andykarpov/karabas-go-pcb/README.md

# Karabas-Go PCB

A Spartan-6 based devboard.

### Pre-production renders:

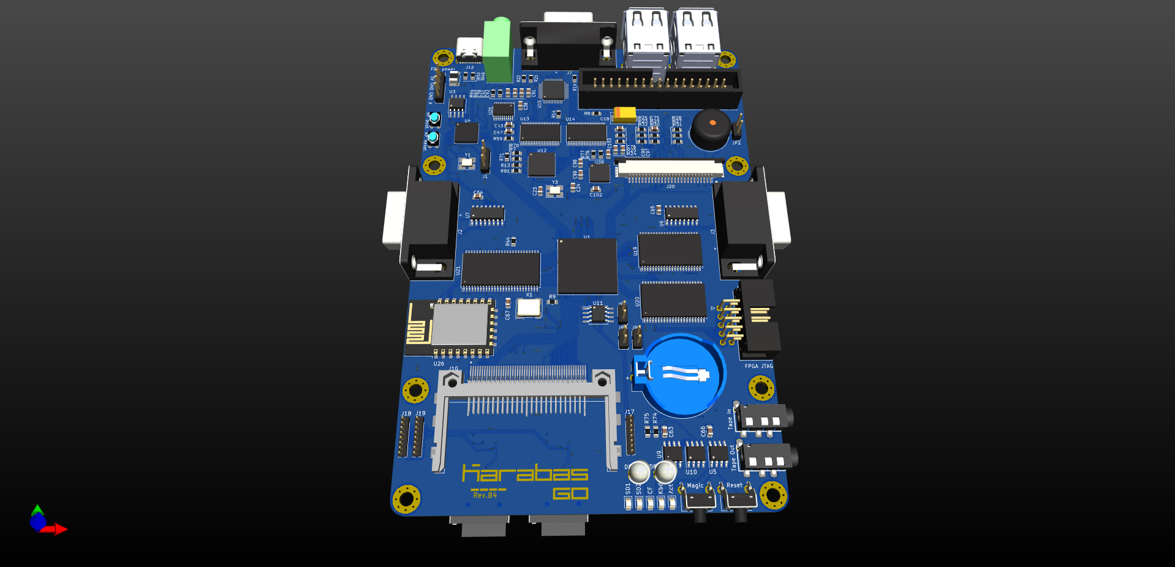
[picture p1: karabas-go-top.png]


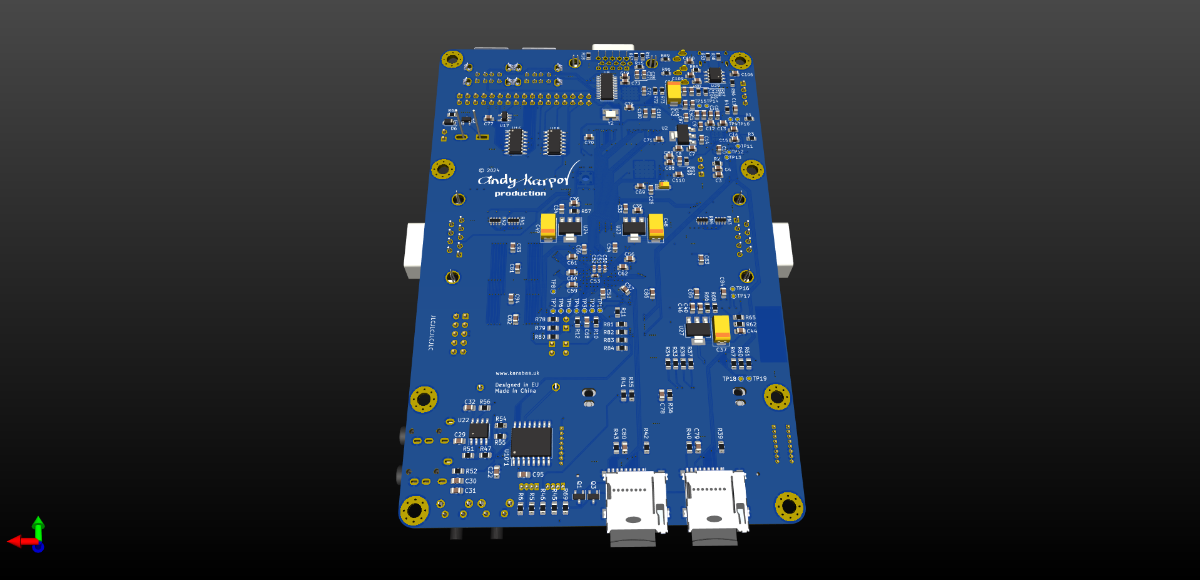
[picture p2: karabas-go-bot.png]
