andykarpov/karabas-go-pcb/Hotfix-DSKCHG_rus.md

# Доработка: DSKCHG разъёма дисковода (все ревизии A..C)

Pin 34 разъёма J8 (DSKCHG, «диск сменён») на плате не используется, поэтому ядра могли только
угадывать, когда диск вынули или вставили. Доработка заводит pin 34 на RP2040, прошивка передаёт
сигнал ядру (`CMD_FDD_CHNG`, karabas-go-firmware `docs/protocol.md`). Платы без доработки работают
как раньше.

Схема этого места одинакова во всех ревизиях от A до C: у U18 (74LVC14, SO-14) свободен один
инвертор (вход pin 5 на GND, выход pin 6 никуда не подключён), TP15 (RP2040 GPIO28) — свободная
контрольная точка.

## Что сделать

1. U18 pin 5: отогнуть ногу от площадки (площадка — GND). В воздухе её не оставлять.
2. Соединить J8 pin 34 с отогнутой ногой U18 pin 5.
3. Резистор 1k с U18 pin 5 на VCC (+5 V), как R23..R26 у INDEX / TR00 / WPRT / RDATA. Выход
   дисковода — открытый коллектор: подтяжка ставится на плате, а не в дисководе. Вход 74LVC
   выдерживает 5 V.
4. Соединить U18 pin 6 с TP15 (GPIO28).

Через инвертор на GPIO28 высокий уровень, когда выбранный дисковод сообщает о смене диска.

## Проверка

С `debug=1` в `karabas.ini` прошивка при старте пишет в лог:

- `Floppy DSKCHG line on GPIO28 (hotfix)` — провод на месте;
- `No floppy DSKCHG line` — GPIO28 свободна (доработки нет или нет контакта с U18 pin 6).

Прошивка читает GPIO28 с подтяжкой вверх и с подтяжкой вниз: свободная площадка идёт за
подтяжкой, а выход инвертора держит уровень сам.

## Дисководы

PC-дисководы 3.5" выдают DSKCHG на pin 34. У некоторых есть перемычка DC / RDY, которая выводит
туда READY: её нужно поставить в DC. У дисководов Amiga на pin 2 стоит _CHNG, а на pin 34 _RDY,
для них нужен PC-дисковод или переходник.

## Следующая ревизия

Развести U18 pin 6 на GPIO28 и на плате (тогда одна прошивка и одни битстримы для всех плат).
