andykarpov/karabas-go-pcb/fab/karabas-go-bom-slx25.xlsx

Comment | Designator | Footprint | JLCPCB Part #（optional）
XC6SLX25-FTG256 | U1 | BGA-256_17.0x17.0mm_Layout16x16_P1.0mm_Ball0.5mm_Pad0.4mm_NSMD | C41894
