andykarpov/karabas-go-pcb/fab/karabas-go-bom.xlsx

Comment | Designator | Footprint | JLCPCB Part #（optional）
RP Boot | BTN1 | SW_SPST_PTS810_handsoldering | C221896
RP Reset | BTN2 | SW_SPST_PTS810_handsoldering | C221896
10uF | C18,C20 | CP_EIA-7343-31_Kemet-D-uni | C167093
18pF | C23,C24 | C_0805_2012Metric_Pad1.18x1.45mm_HandSolder | C1797
4u7 | C25 | C_0805_2012Metric_Pad1.18x1.45mm_HandSolder | C1779
22pF | C3,C4 | C_0805_2012Metric_Pad1.18x1.45mm_HandSolder | C1804
3n3 | C31 | C_0805_2012Metric_Pad1.18x1.45mm_HandSolder | C1744
100uF | C37,C48,C49 | CP_EIA-7343-31_Kemet-D-uni | C710451
2n2 | C38,C42,C45 | C_0805_2012Metric_Pad1.18x1.45mm_HandSolder | C28260
10u | C43,C39,C7,C1 | C_0805_2012Metric_Pad1.18x1.45mm_HandSolder | C15850
100n | C57,C61,C60,C54,C50,C52,C53,C51,C59,C55,C58,C62,C56 | C_0402_1005Metric_Pad0.74x0.62mm_HandSolder | C1525
100n | C65,C63,C17,C41,C75,C66,C67,C76,C21,C77,C22,C64,C47,C27,C34,C72,C71,C84,C15,C74,C26,C32,C13,C79,C11,C70,C36,C16,C68,C33,C78,C12,C81,C5,C14,C10,C46,C94,C19,C69,C73,C87,C44,C93,C85,C83,C40,C29,C6,C80,C86,C35,C9,C82,C30 | C_0805_2012Metric_Pad1.18x1.45mm_HandSolder | C49678
1u | C8,C28,C2 | C_0805_2012Metric_Pad1.18x1.45mm_HandSolder | C28323
4n7 | C88,C90,C89 | C_0805_2012Metric_Pad1.18x1.45mm_HandSolder | C1744
470n | C91,C92 | C_0805_2012Metric_Pad1.18x1.45mm_HandSolder | C13967
Keyboard | D1 | LED_0805_2012Metric_Pad1.15x1.40mm_HandSolder | C2297
Activitty | D2 | LED_0805_2012Metric_Pad1.15x1.40mm_HandSolder | C84256
SD 2 | D4 | LED_0805_2012Metric_Pad1.15x1.40mm_HandSolder | C2296
CF | D5 | LED_0805_2012Metric_Pad1.15x1.40mm_HandSolder | C2296
1N4148W | D6 | D_SOD-123 | C81598
SD 1 | D7 | LED_0805_2012Metric_Pad1.15x1.40mm_HandSolder | C2296
6V 2A | F1 | Fuse_1812_4532Metric_Pad1.30x3.40mm_HandSolder | C883156
CF Card | J10 | TE_1734451-1-LONG | C2962036
USB C | J12 | USB_C_Receptacle_XKB_U262-16XN-4BVC11 | C2927037
uSD card | J9,J11 | Conn_uSDcard | C111196
BC856 | Q1,Q3 | SOT-23 | C8326
BC847 | Q2 | SOT-23 | C20526
10k | R14,R13,R44,R43,R62,R61,R10,R42,R12,R65,R3,R11,R60,R39,R4,R40,R68 | R_0805_2012Metric_Pad1.20x1.40mm_HandSolder | C17414
0* | R18 | R_0805_2012Metric_Pad1.20x1.40mm_HandSolder | C17477
75 | R20,R19,R16,R15,R17 | R_0805_2012Metric_Pad1.20x1.40mm_HandSolder | C17408
22 | R21 | R_0805_2012Metric_Pad1.20x1.40mm_HandSolder | C17561
510 | R22 | R_0805_2012Metric_Pad1.20x1.40mm_HandSolder | C17734
330 | R30,R27,R31,R28,R32,R29 | R_0805_2012Metric_Pad1.20x1.40mm_HandSolder | C17630
100 | R33,R34,R37,R38 | R_0805_2012Metric_Pad1.20x1.40mm_HandSolder | C17408
1M | R47 | R_0805_2012Metric_Pad1.20x1.40mm_HandSolder | C17514
0 | R49,R50 | R_0805_2012Metric_Pad1.20x1.40mm_HandSolder | C17477
33k | R52 | R_0805_2012Metric_Pad1.20x1.40mm_HandSolder | C17633
5k1 | R53,R51,R48 | R_0805_2012Metric_Pad1.20x1.40mm_HandSolder | C27834
300 | R57 | R_0805_2012Metric_Pad1.20x1.40mm_HandSolder | C17617
15k* | R58 | R_0805_2012Metric_Pad1.20x1.40mm_HandSolder | C17475
470 | R63,R64,R5,R6,R45,R46,R67,R69 | R_0805_2012Metric_Pad1.20x1.40mm_HandSolder | C17710
1k | R7,R23,R71,R26,R25,R70,R24,R59,R55,R66,R41,R36,R2,R35,R1,R54,R56 | R_0805_2012Metric_Pad1.20x1.40mm_HandSolder | C17513
10k* | R73,R72 | R_0805_2012Metric_Pad1.20x1.40mm_HandSolder | C17414
4k7 | R75,R74 | R_0805_2012Metric_Pad1.20x1.40mm_HandSolder | C17673
2k7 | R8 | R_0805_2012Metric_Pad1.20x1.40mm_HandSolder | C17530
27 | R9 | R_0805_2012Metric_Pad1.20x1.40mm_HandSolder | C17594
10k | RN4,RN3,RN1,RN2 | R_Array_Convex_4x0603 | C110924
XC6SLX25-FTG256 | U1 | BGA-256_17.0x17.0mm_Layout16x16_P1.0mm_Ball0.5mm_Pad0.4mm_NSMD | C41894
DS3231MZ | U10 | SO-8_3.9x4.9mm_P1.27mm | C107410
W25Q128JVSIQ | U11,U3 | SOIC-8_5.23x5.23mm_P1.27mm | C97521
FT812Q-T | U12 | QFN-56-1EP_8x8mm_P0.5mm_EP5.9x5.9mm_ThermalVias | C3824176
MC74LCX16245DT | U13,U14 | TSSOP-48_6.1x12.5mm_P0.5mm | C233628
ADV7125BCPZ170 | U15 | QFN-48-1EP_7x7mm_P0.5mm_EP5.1x5.1mm_ThermalVias | C662235
74LVC06 | U16 | SO-14_3.9x8.65mm_P1.27mm | C7658
74LVC1G06 | U17 | SOT-23-5_HandSoldering | C840103
74LVC14 | U18 | SO-14_3.9x8.65mm_P1.27mm | C354441
IS61WV20488BLL-10TLI | U19,U20 | TSOP-II-44_10.16x18.41mm_P0.8mm
LM1117MP-3.3 | U2,U27,U23 | SOT-223-3_TabPin2 | C498153
MT48LC16M16A2TG | U21 | TSOP-II-54_22.2x10.16mm_P0.8mm | C26393
LM311 | U22 | SO-8_3.9x4.9mm_P1.27mm | C2868397
LM1117MP-1.2 | U24 | SOT-223-3_TabPin2 | C126025
PCM5102A | U25 | TSSOP-20_4.4x6.5mm_P0.65mm | C107671
RP2040 | U4 | RP2040-QFN-56 | C2040
PCA9536D | U5 | SOIC-8_3.9x4.9mm_P1.27mm | C2688883
74HC597 | U7,U6 | SO-16_3.9x9.9mm_P1.27mm | C521193
FE1.1s | U8 | SSOP-28_3.9x9.9mm_P0.635mm | C9359
24LC08B | U9 | SO-8_3.9x4.9mm_P1.27mm | C5455
50 MHz | X1 | Oscillator_SMD_SeikoEpson_SG8002CA-4Pin_7.0x5.0mm | C387130
12MHz | Y1,Y2 | Crystal_SMD_3225-4Pin_3.2x2.5mm_HandSoldering | C9002
8MHz | Y3 | Crystal_SMD_3225-4Pin_3.2x2.5mm_HandSoldering | C367183
