andykarpov/karabas-go-pcb/3d_models/karabas-go-revB4.step

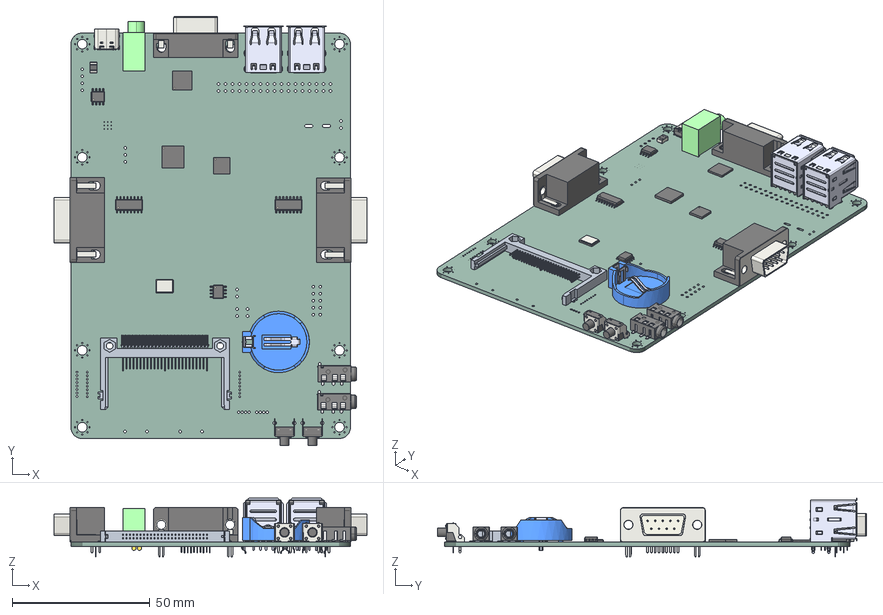
[picture p4: CAD file, 2026-05-14]
3d_models/karabas-go-revB4.step
113.7 x 155.9 x 21.4 mm
DSUB_30_female
Crystal_SMD_TXC_7M-4Pin_3.2x2.5mm_HandSoldering
SOIC_8_39x49mm_P127mm x 2
SW_Tactile_SPST_Angled_PTS645Vx58-2LFS x 2
BS-7-BLUE
Fuse_1210_3225Metric
USB_C_Receptacle_16P_TopMnt_Horizontal_GCT_USB4105-xx-A
QFN_56_1EP_8x8mm_Pitch05mm_EP52x45mm
DSUB-9_Male_Horizontal_P2.77x2.84mm_EdgePinOffset7.70mm_Housed_ MountingHolesOffset9.12mm x 2
SOIC_16_39x99mm_P127mm x 2
SS-52100-003 x 2
User Library-PJ325
PJ320D x 2
QFN-48-1EP_7x7mm_Pitch0.5mm
C-1734451-1
UQFN-48-1EP_6x6mm_Pitch0.4mm
karabas-go PCB
