andykarpov/karabas-go-pcb/Errata-revA_rus.txt

Хотфиксы revA:

1) засоплить между собой выводы 43 и 44 RP2040

2) C27 посажен на GND, желательно перекинуть его на ближайший VCC33

3) C38 должен быть 2.2мкФ, по бому неправильный - 2.2нФ

4) ноги 1,24 у буферов U13, U14 посажены на VCC33, надо отрезать их и засоплить ноги на GND
