andykarpov/karabas-go-pcb/(commit log)

2023-08-04 annotated schematics
2023-08-05 Changed memory to ISSI, some pcb placement wip
2023-08-11 revA gerbers, schematics
2023-08-11 fixed 7406 footprint
2023-12-31 PCB Rev.B - initial changes with all Rev.A hotfixes for the moment
2024-01-01 Added ADV7125 universal footprint QFN/QFP
2024-01-01 RevB compressed gerbers
2024-01-02 Fixed FE1.1 footprint, increased power rails width
2024-01-06 Updated revB pcb - changed footprints of the FPGA capacitors, swapped rp2040 test points
2024-01-06 Added revB gerbers
2024-01-06 Added revB schematics
2024-02-08 Updated buzzer footprint
2024-02-15 Added FT_PD reset circuit, routed to MCU TP9
2024-02-16 Added ext connector for 3rd SD card
2024-02-16 Updated revB2: added additional ext connectors for SD cards
2024-02-16 Silkscreen updates
2024-03-03 Compressed gerbers revB3
2024-04-09 Updated revB4 schematics
2026-05-14 3d models of the whole pcb (incomplete)
2026-11-01 Hotfix: DSKCHG (pin 34) of the floppy connector through the free gate of U18 to TP15 / GPIO28
    All revisions A..C: U18 (74LVC14) pin 5 lifted off GND, J8.34 to it with 1k to VCC, U18 pin 6
    to TP15 (RP2040 GPIO28). The firmware finds the wire and passes DSKCHG to the cores
    (CMD_FDD_CHNG of karabas-go-firmware).
