andykarpov/karabas-go-pcb/karabas-go.kicad_pcb

## KiCad design karabas-go.kicad_pcb (2024-04-09)

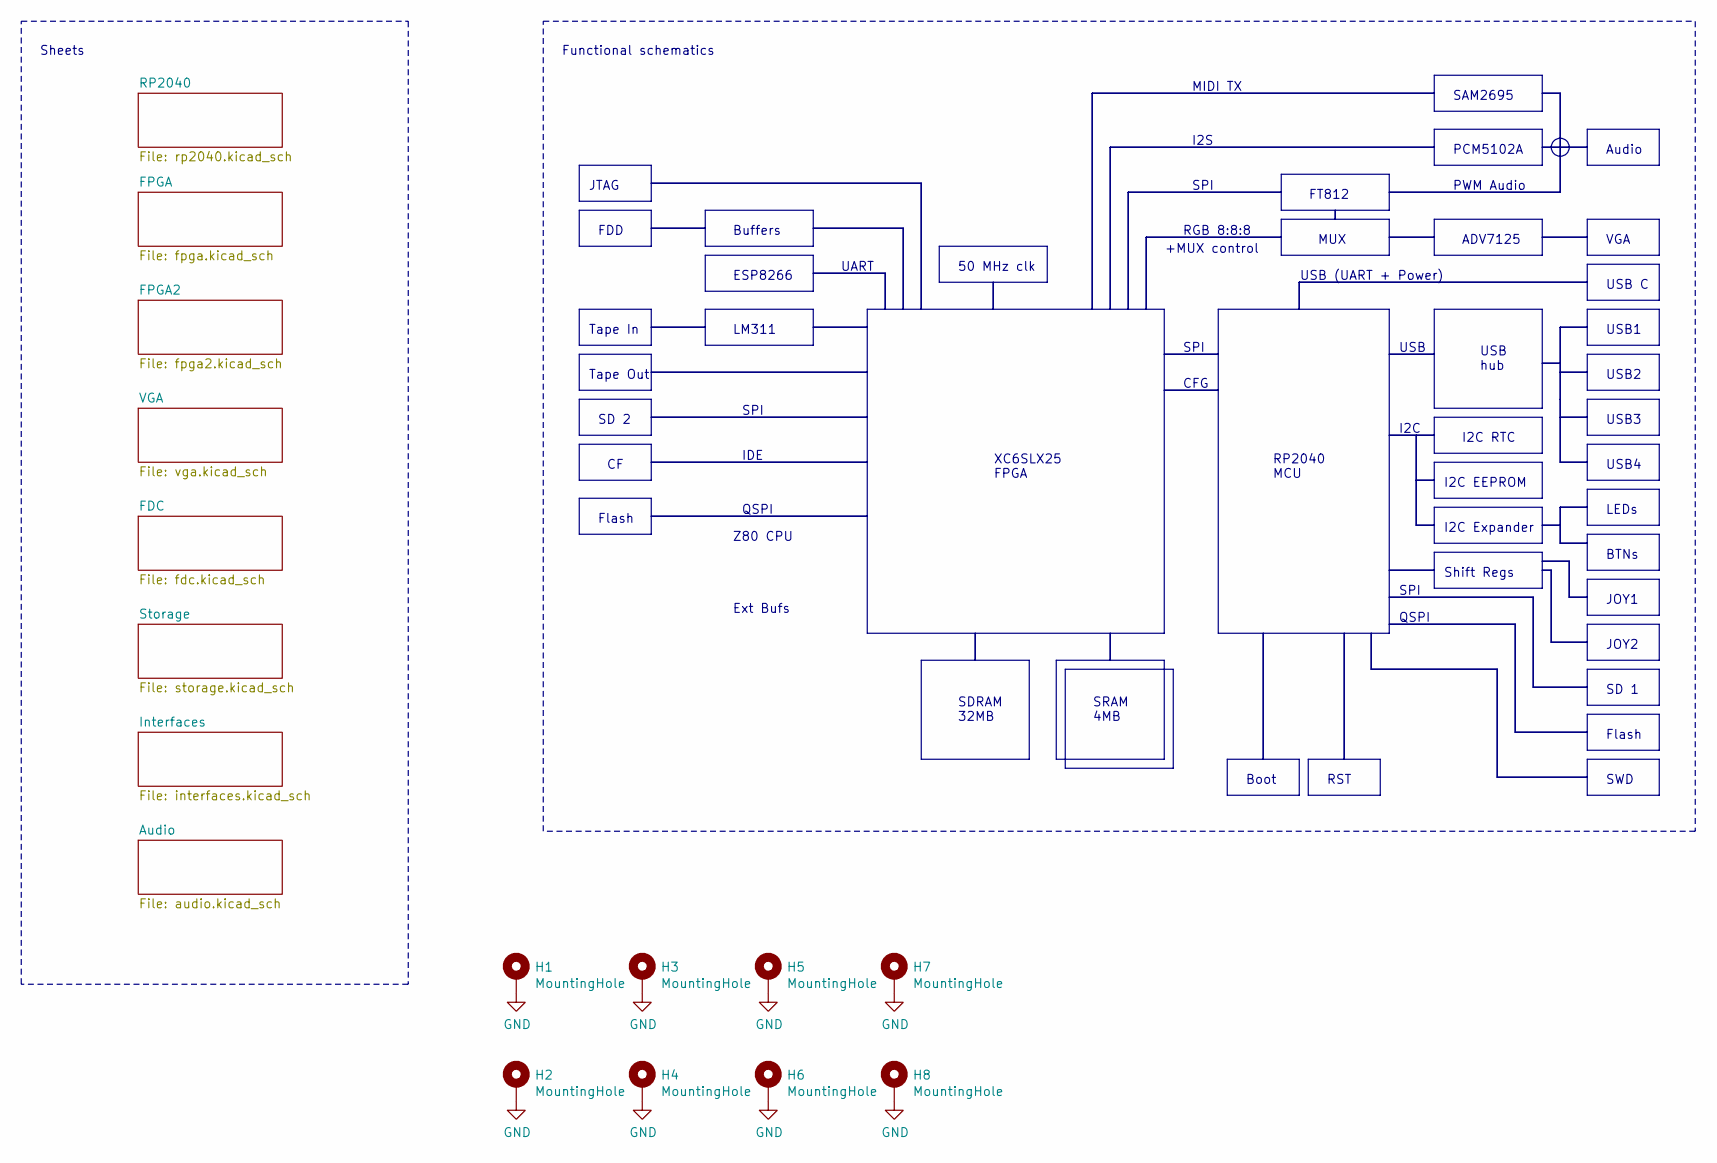
[picture p2: schematic karabas-go.kicad_sch]

Parts:
H1, H2, H3, H4, H5, H6, H7, H8: MountingHole; MountingHole_3.5mm_Pad_Via

Connections:
GND: H1.1, H2.1, H3.1, H4.1, H5.1, H6.1, H7.1, H8.1; also elsewhere on the board

Notes on the sheet:
QSPI
MIDI TX
I2C
I2C RTC
Tape Out
JTAG
SD 2
SAM2695
VGA
USB2
USB1
I2C EEPROM
JOY2
SWD
XC6SLX25 FPGA
RGB 8:8:8
Tape In
UART
RST
I2S
USB hub
50 MHz clk
SD 1
Z80 CPU
SPI
LM311
JOY1
IDE
ADV7125
Shift Regs
USB4
PWM Audio
Ext Bufs
SRAM 4MB
I2C Expander
FT812
+MUX control
Functional schematics
SDRAM 32MB
LEDs
CFG
USB (UART + Power)
USB C
Audio
USB
USB3
PCM5102A
Buffers
Boot
ESP8266
MUX
Flash
FDD
Sheets
BTNs
RP2040 MCU

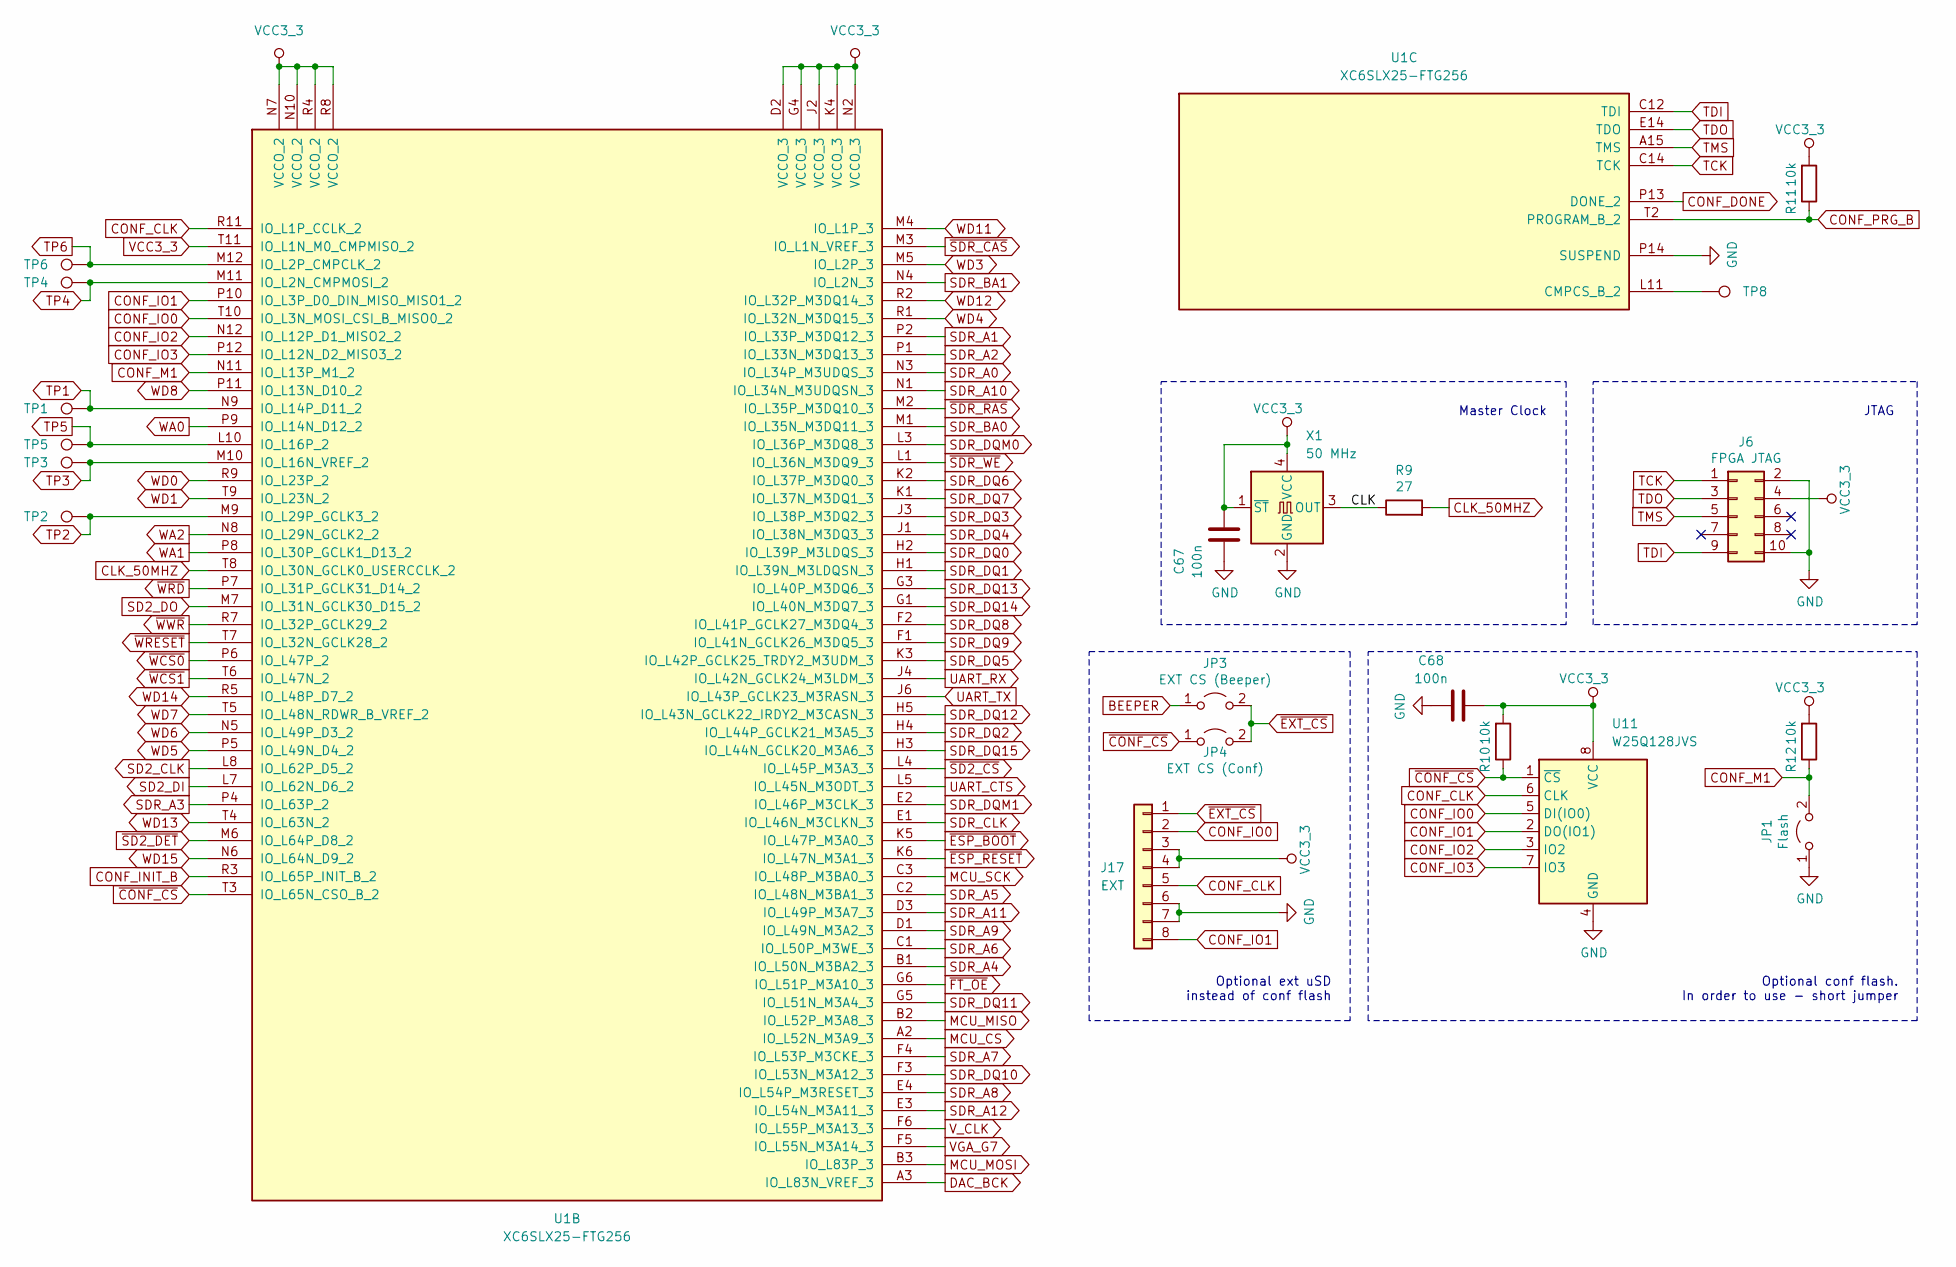
[picture p3: schematic fpga2.kicad_sch, Karabas-Go]

Parts:
C67, C68: 100n; C_0805_2012Metric_Pad1.18x1.45mm_HandSolder
J6: FPGA JTAG; IDC-Header_2x05_P2.54mm_Horizontal
J17: EXT; PinHeader_1x08_P1.27mm_Vertical
JP1: Flash; PinHeader_1x02_P2.54mm_Vertical
JP3: EXT CS (Beeper); PinHeader_1x02_P2.54mm_Vertical
JP4: EXT CS (Conf); PinHeader_1x02_P2.54mm_Vertical
R9: 27; R_0805_2012Metric_Pad1.20x1.40mm_HandSolder
R10, R11, R12: 10k; R_0805_2012Metric_Pad1.20x1.40mm_HandSolder
TP1, TP2, TP3, TP4, TP5, TP6, TP8: TestPoint; TestPoint_Pad_D1.0mm
U1: XC6SLX25-FTG256; BGA-256_17.0x17.0mm_Layout16x16_P1.0mm_Ball0.5mm_Pad0.4mm_N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
U11: W25Q128JVS; SOIC-8_5.23x5.23mm_P1.27mm
X1: 50 MHz; Oscillator_SMD_SeikoEpson_SG8002CA-4Pin_7.0x5.0mm

Connections:
/FPGA2/CLK: R9.1, X1.3 (OUT)
BEEPER: JP3.1 (A); also elsewhere on the board
CLK_50MHZ: R9.2, U1.T8 (IO_L30N_GCLK0_USERCCLK_2)
CONF_CLK: J17.5, U1.R11 (IO_L1P_CCLK_2), U11.6 (CLK); also elsewhere on the board
CONF_DONE: U1.P13 (DONE_2); also elsewhere on the board
CONF_INIT_B: U1.R3 (IO_L65P_INIT_B_2); also elsewhere on the board
CONF_IO0: J17.2, U1.T10 (IO_L3N_MOSI_CSI_B_MISO0_2), U11.5 (DI(IO0))
CONF_IO1: J17.8, U1.P10 (IO_L3P_D0_DIN_MISO_MISO1_2), U11.2 (DO(IO1)); also elsewhere on the board
CONF_IO2: U1.N12 (IO_L12P_D1_MISO2_2), U11.3 (IO2)
CONF_IO3: U1.P12 (IO_L12N_D2_MISO3_2), U11.7 (IO3)
CONF_M1: JP1.2 (B), R12.1, U1.N11 (IO_L13P_M1_2)
CONF_PRG_B: R11.1, U1.T2 (PROGRAM_B_2); also elsewhere on the board
DAC_BCK: U1.A3 (IO_L83N_VREF_3); also elsewhere on the board
GND: C67.2, C68.2, J6.2, J6.10, J17.6, J17.7, JP1.1 (A), U1.P14 (SUSPEND), U11.4 (GND), X1.2 (GND); also elsewhere on the board
MCU_CS: U1.A2 (IO_L52N_M3A9_3); also elsewhere on the board
MCU_MISO: U1.B2 (IO_L52P_M3A8_3); also elsewhere on the board
MCU_MOSI: U1.B3 (IO_L83P_3); also elsewhere on the board
MCU_SCK: U1.C3 (IO_L48P_M3BA0_3); also elsewhere on the board
unnamed: TP8.1, U1.L11 (CMPCS_B_2)
SD2_CLK: U1.L8 (IO_L62P_D5_2); also elsewhere on the board
SD2_DI: U1.L7 (IO_L62N_D6_2); also elsewhere on the board
SD2_DO: U1.M7 (IO_L31N_GCLK30_D15_2); also elsewhere on the board
SDR_A0: U1.N3 (IO_L34P_M3UDQS_3); also elsewhere on the board
SDR_A1: U1.P2 (IO_L33P_M3DQ12_3); also elsewhere on the board
SDR_A2: U1.P1 (IO_L33N_M3DQ13_3); also elsewhere on the board
SDR_A3: U1.P4 (IO_L63P_2); also elsewhere on the board
SDR_A4: U1.B1 (IO_L50N_M3BA2_3); also elsewhere on the board
SDR_A5: U1.C2 (IO_L48N_M3BA1_3); also elsewhere on the board
SDR_A6: U1.C1 (IO_L50P_M3WE_3); also elsewhere on the board
SDR_A7: U1.F4 (IO_L53P_M3CKE_3); also elsewhere on the board
SDR_A8: U1.E4 (IO_L54P_M3RESET_3); also elsewhere on the board
SDR_A9: U1.D1 (IO_L49N_M3A2_3); also elsewhere on the board
SDR_A10: U1.N1 (IO_L34N_M3UDQSN_3); also elsewhere on the board
SDR_A11: U1.D3 (IO_L49P_M3A7_3); also elsewhere on the board
SDR_A12: U1.E3 (IO_L54N_M3A11_3); also elsewhere on the board
SDR_BA0: U1.M1 (IO_L35N_M3DQ11_3); also elsewhere on the board
SDR_BA1: U1.N4 (IO_L2N_3); also elsewhere on the board
SDR_CLK: U1.E1 (IO_L46N_M3CLKN_3); also elsewhere on the board
SDR_DQ0: U1.H2 (IO_L39P_M3LDQS_3); also elsewhere on the board
SDR_DQ1: U1.H1 (IO_L39N_M3LDQSN_3); also elsewhere on the board
SDR_DQ2: U1.H4 (IO_L44P_GCLK21_M3A5_3); also elsewhere on the board
SDR_DQ3: U1.J3 (IO_L38P_M3DQ2_3); also elsewhere on the board
SDR_DQ4: U1.J1 (IO_L38N_M3DQ3_3); also elsewhere on the board
SDR_DQ5: U1.K3 (IO_L42P_GCLK25_TRDY2_M3UDM_3); also elsewhere on the board
SDR_DQ6: U1.K2 (IO_L37P_M3DQ0_3); also elsewhere on the board
SDR_DQ7: U1.K1 (IO_L37N_M3DQ1_3); also elsewhere on the board
SDR_DQ8: U1.F2 (IO_L41P_GCLK27_M3DQ4_3); also elsewhere on the board
SDR_DQ9: U1.F1 (IO_L41N_GCLK26_M3DQ5_3); also elsewhere on the board
SDR_DQ10: U1.F3 (IO_L53N_M3A12_3); also elsewhere on the board
SDR_DQ11: U1.G5 (IO_L51N_M3A4_3); also elsewhere on the board
SDR_DQ12: U1.H5 (IO_L43N_GCLK22_IRDY2_M3CASN_3); also elsewhere on the board
SDR_DQ13: U1.G3 (IO_L40P_M3DQ6_3); also elsewhere on the board
SDR_DQ14: U1.G1 (IO_L40N_M3DQ7_3); also elsewhere on the board
SDR_DQ15: U1.H3 (IO_L44N_GCLK20_M3A6_3); also elsewhere on the board
SDR_DQM0: U1.L3 (IO_L36P_M3DQ8_3); also elsewhere on the board
SDR_DQM1: U1.E2 (IO_L46P_M3CLK_3); also elsewhere on the board
TCK: J6.1, U1.C14 (TCK)
TDI: J6.9, U1.C12 (TDI)
TDO: J6.3, U1.E14 (TDO)
TMS: J6.5, U1.A15 (TMS)
TP1: TP1.1, U1.N9 (IO_L14P_D11_2); also elsewhere on the board
TP2: TP2.1, U1.M9 (IO_L29P_GCLK3_2); also elsewhere on the board
TP3: TP3.1, U1.M10 (IO_L16N_VREF_2); also elsewhere on the board
TP4: TP4.1, U1.M11 (IO_L2N_CMPMOSI_2); also elsewhere on the board
TP5: TP5.1, U1.L10 (IO_L16P_2); also elsewhere on the board
TP6: TP6.1, U1.M12 (IO_L2P_CMPCLK_2); also elsewhere on the board
UART_CTS: U1.L5 (IO_L45N_M3ODT_3); also elsewhere on the board
UART_RX: U1.J4 (IO_L42N_GCLK24_M3LDM_3); also elsewhere on the board
UART_TX: U1.J6 (IO_L43P_GCLK23_M3RASN_3); also elsewhere on the board
VCC3_3: C67.1, C68.1, J6.4, J17.3, J17.4, R10.2, R11.2, R12.2, U1.D2 (VCCO_3), U1.G4 (VCCO_3), U1.J2 (VCCO_3), U1.K4 (VCCO_3), U1.N2 (VCCO_3), U1.N7 (VCCO_2), U1.N10 (VCCO_2), U1.R4 (VCCO_2), U1.R8 (VCCO_2), U1.T11 (IO_L1N_M0_CMPMISO_2), U11.8 (VCC), X1.1 (~ST), X1.4 (VCC); also elsewhere on the board
VGA_G7: U1.F5 (IO_L55N_M3A14_3); also elsewhere on the board
V_CLK: U1.F6 (IO_L55P_M3A13_3); also elsewhere on the board
WA0: U1.P9 (IO_L14N_D12_2); also elsewhere on the board
WA1: U1.P8 (IO_L30P_GCLK1_D13_2); also elsewhere on the board
WA2: U1.N8 (IO_L29N_GCLK2_2); also elsewhere on the board
WD0: U1.R9 (IO_L23P_2); also elsewhere on the board
WD1: U1.T9 (IO_L23N_2); also elsewhere on the board
WD3: U1.M5 (IO_L2P_3); also elsewhere on the board
WD4: U1.R1 (IO_L32N_M3DQ15_3); also elsewhere on the board
WD5: U1.P5 (IO_L49N_D4_2); also elsewhere on the board
WD6: U1.N5 (IO_L49P_D3_2); also elsewhere on the board
WD7: U1.T5 (IO_L48N_RDWR_B_VREF_2); also elsewhere on the board
WD8: U1.P11 (IO_L13N_D10_2); also elsewhere on the board
WD11: U1.M4 (IO_L1P_3); also elsewhere on the board
WD12: U1.R2 (IO_L32P_M3DQ14_3); also elsewhere on the board
WD13: U1.T4 (IO_L63N_2); also elsewhere on the board
WD14: U1.R5 (IO_L48P_D7_2); also elsewhere on the board
WD15: U1.N6 (IO_L64N_D9_2); also elsewhere on the board
~CONF_CS: JP4.1 (A), R10.1, U1.T3 (IO_L65N_CSO_B_2), U11.1 (~CS)
~ESP_BOOT: U1.K5 (IO_L47P_M3A0_3); also elsewhere on the board
~ESP_RESET: U1.K6 (IO_L47N_M3A1_3); also elsewhere on the board
~EXT_CS: J17.1, JP3.2 (B), JP4.2 (B)
~FT_OE: U1.G6 (IO_L51P_M3A10_3); also elsewhere on the board
~SD2_CS: U1.L4 (IO_L45P_M3A3_3); also elsewhere on the board
~SD2_DET: U1.M6 (IO_L64P_D8_2); also elsewhere on the board
~SDR_CAS: U1.M3 (IO_L1N_VREF_3); also elsewhere on the board
~SDR_RAS: U1.M2 (IO_L35P_M3DQ10_3); also elsewhere on the board
~SDR_WE: U1.L1 (IO_L36N_M3DQ9_3); also elsewhere on the board
~WCS0: U1.P6 (IO_L47P_2); also elsewhere on the board
~WCS1: U1.T6 (IO_L47N_2); also elsewhere on the board
~WRD: U1.P7 (IO_L31P_GCLK31_D14_2); also elsewhere on the board
~WRESET: U1.T7 (IO_L32N_GCLK28_2); also elsewhere on the board
~WWR: U1.R7 (IO_L32P_GCLK29_2); also elsewhere on the board

Notes on the sheet:
JTAG
Optional ext uSD instead of conf flash
Optional conf flash. In order to use - short jumper
Master Clock

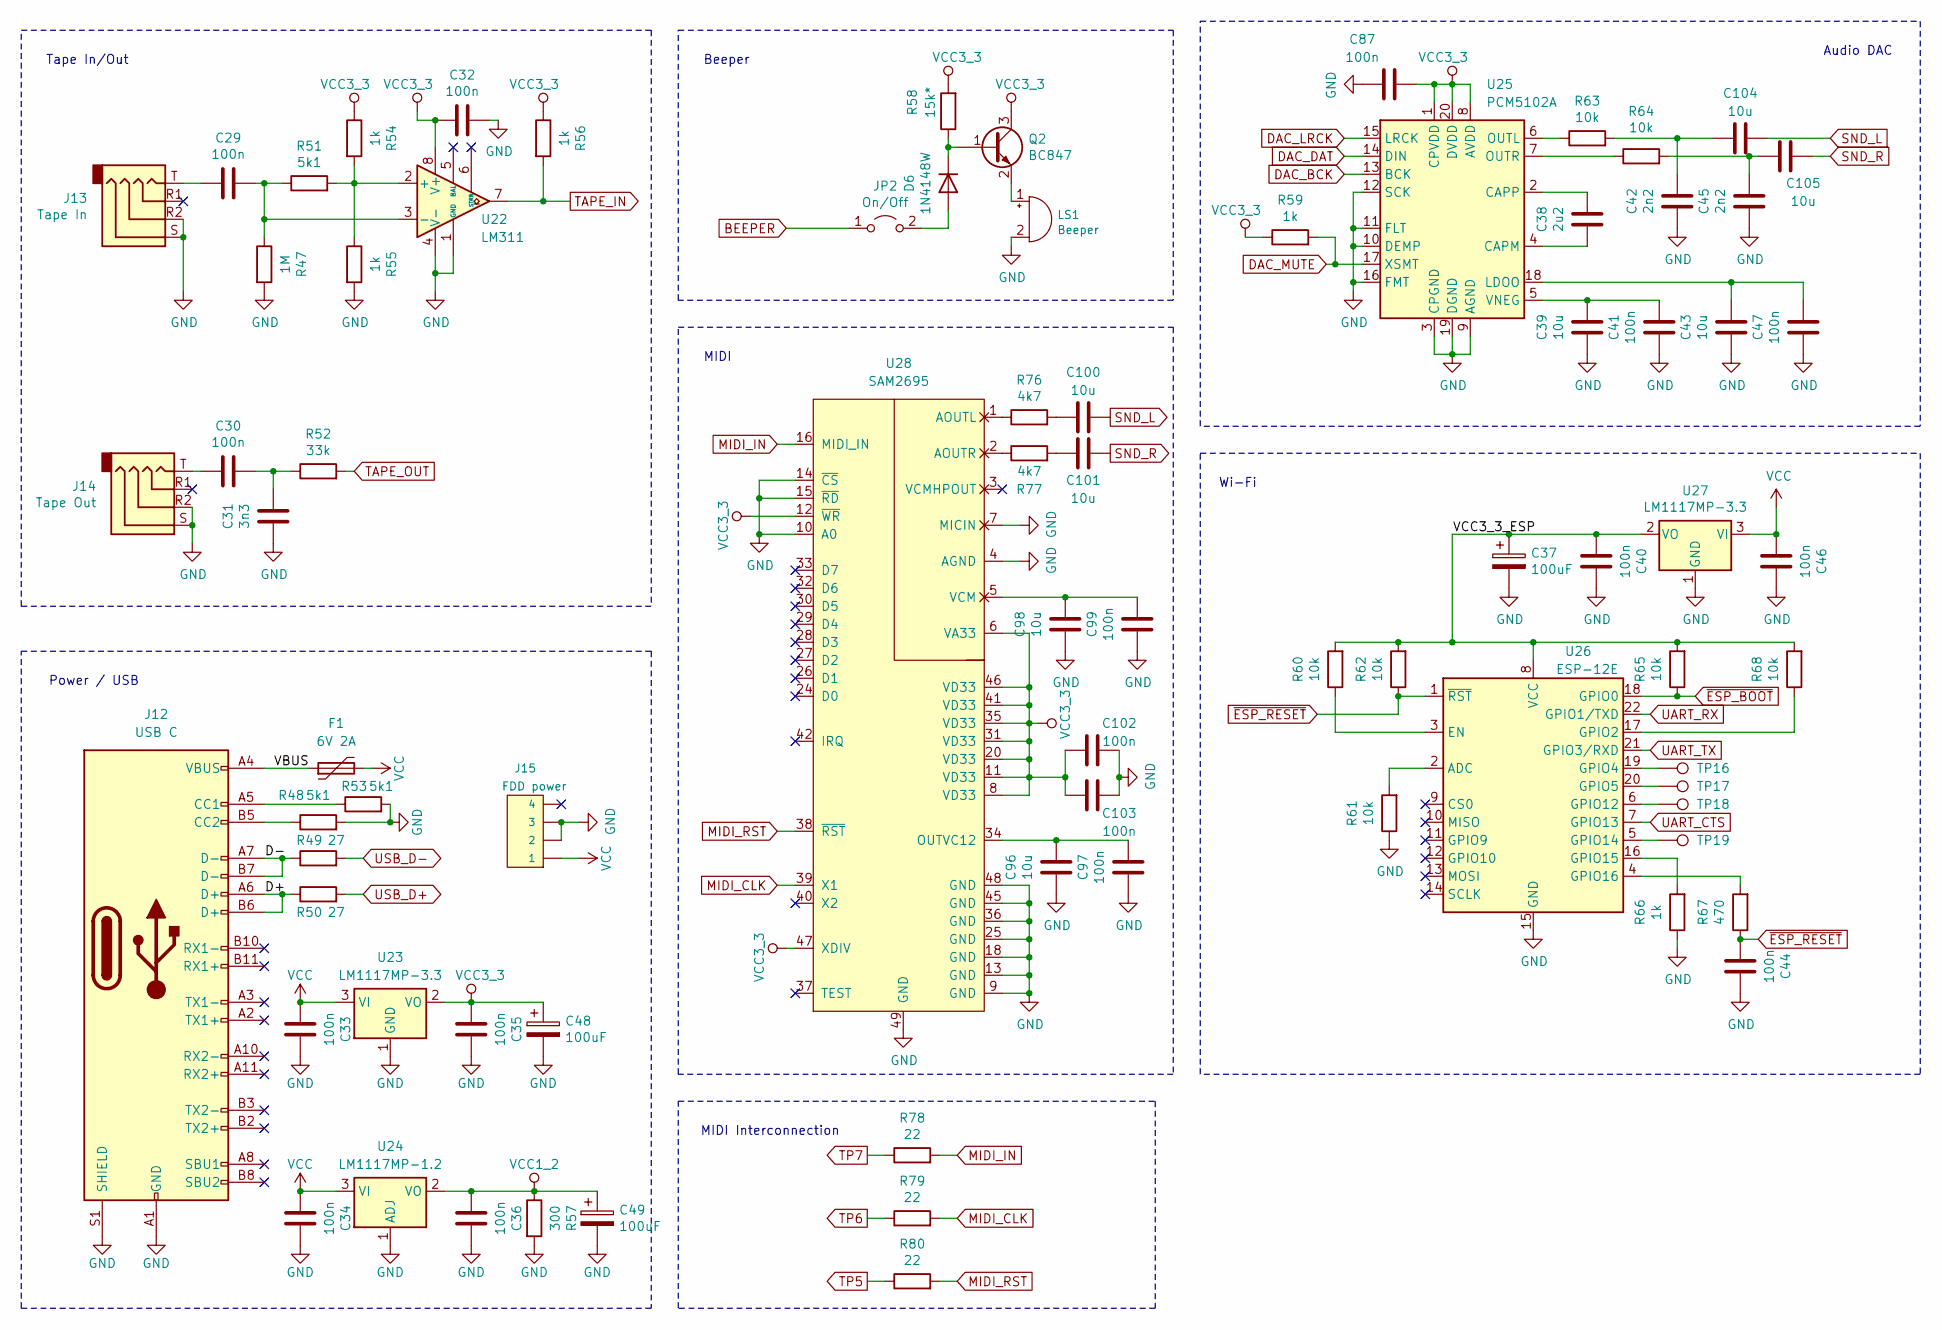
[picture p4: schematic interfaces.kicad_sch, Karabas-Go]

Parts:
C29, C30, C32, C33, C34, C35, C36, C40, C41, C44, C46, C47, C87, C97, C99, C102, C103: 100n; C_0805_2012Metric_Pad1.18x1.45mm_HandSolder
C31: 3n3; C_0805_2012Metric_Pad1.18x1.45mm_HandSolder
C37, C48, C49: 100uF; CP_EIA-7343-31_Kemet-D-uni
C38: 2u2; C_0805_2012Metric_Pad1.18x1.45mm_HandSolder
C39, C43, C96, C98, C100, C101, C104, C105: 10u; C_0805_2012Metric_Pad1.18x1.45mm_HandSolder
C42, C45: 2n2; C_0805_2012Metric_Pad1.18x1.45mm_HandSolder
D6: 1N4148W; D_SOD-123
F1: 6V 2A; Fuse_1812_4532Metric_Pad1.30x3.40mm_HandSolder
J12: USB C; USB_C_Receptacle_XKB_U262-16XN-4BVC11
J13: Tape In; AUDIO_JACK_3.5MM_SMD_TRRS_rounded_mixed
J14: Tape Out; AUDIO_JACK_3.5MM_SMD_TRRS_rounded_mixed
J15: FDD power; PinHeader_1x04_P2.54mm_Vertical
JP2: On/Off; PinHeader_1x02_P2.54mm_Vertical
LS1: Beeper; Buzzer_TDK_PS1240P02BT_D12.2mm_H6.5mm_long
Q2: BC847; SOT-23
R47: 1M; R_0805_2012Metric_Pad1.20x1.40mm_HandSolder
R48, R51, R53: 5k1; R_0805_2012Metric_Pad1.20x1.40mm_HandSolder
R49, R50: 27; R_0805_2012Metric_Pad1.20x1.40mm_HandSolder
R52: 33k; R_0805_2012Metric_Pad1.20x1.40mm_HandSolder
R54, R55, R56, R59, R66: 1k; R_0805_2012Metric_Pad1.20x1.40mm_HandSolder
R57: 300; R_0805_2012Metric_Pad1.20x1.40mm_HandSolder
R58: 15k*; R_0805_2012Metric_Pad1.20x1.40mm_HandSolder
R60, R61, R62, R63, R64, R65, R68: 10k; R_0805_2012Metric_Pad1.20x1.40mm_HandSolder
R67: 470; R_0805_2012Metric_Pad1.20x1.40mm_HandSolder
R76, R77: 4k7; R_0805_2012Metric_Pad1.20x1.40mm_HandSolder
R78, R79, R80: 22; R_0805_2012Metric_Pad1.20x1.40mm_HandSolder
TP16, TP17, TP18, TP19: TestPoint; TestPoint_Pad_D1.0mm
U22: LM311; SO-8_3.9x4.9mm_P1.27mm
U23, U27: LM1117MP-3.3; SOT-223-3_TabPin2
U24: LM1117MP-1.2; SOT-223-3_TabPin2
U25: PCM5102A; TSSOP-20_4.4x6.5mm_P0.65mm
U26: ESP-12E
U28: SAM2695; QFN-48-1EP_6x6mm_P0.4mm_EP4.66x4.66mm_BackHoles

Connections:
/Interfaces/D+: J12.A6 (D+), J12.B6 (D+), R50.1
/Interfaces/D-: J12.A7 (D-), J12.B7 (D-), R49.1
/Interfaces/VBUS: F1.1, J12.A4 (VBUS), J12.A9 (VBUS), J12.B4 (VBUS), J12.B9 (VBUS)
/Interfaces/VCC3_3_ESP: C37.1, C40.1, R60.2, R62.2, R65.2, R68.2, U26.8 (VCC), U27.2 (VO)
BEEPER: JP2.1 (A); also elsewhere on the board
DAC_BCK: U25.13 (BCK); also elsewhere on the board
DAC_DAT: U25.14 (DIN); also elsewhere on the board
DAC_LRCK: U25.15 (LRCK); also elsewhere on the board
DAC_MUTE: R59.2, U25.17 (XSMT); also elsewhere on the board
GND: C31.1, C32.2, C33.2, C34.2, C35.2, C36.2, C37.2, C39.1, C40.2, C41.1, C42.1, C43.1, C44.2, C45.1, C46.2, C47.1, C48.2, C49.2, C87.2, C96.1, C97.1, C98.1, C99.1, C102.1, C103.1, J12.A1 (GND), J12.A12 (GND), J12.B1 (GND), J12.B12 (GND), J12.S1 (SHIELD), J13.R2, J13.S, J14.R2, J14.S, J15.2, J15.3, LS1.2 (+), R47.2, R48.2, R53.2, R55.2, R57.2, R61.1, R66.1, U22.1 (GND), U22.4 (V-), U23.1 (GND), U24.1 (ADJ), U25.3 (CPGND), U25.9 (AGND), U25.10 (DEMP), U25.11 (FLT), U25.12 (SCK), U25.16 (FMT), U25.19 (DGND), U26.15 (GND), U27.1 (GND), U28.4 (AGND), U28.7 (MICIN), U28.9 (GND), U28.10 (A0), U28.13 (GND), U28.14 (~CS), U28.15 (~RD), U28.18 (GND), U28.25 (GND), U28.36 (GND), U28.45 (GND), U28.48 (GND), U28.49 (GND); also elsewhere on the board
MIDI_CLK: R79.2, U28.39 (X1)
MIDI_IN: R78.2, U28.16 (MIDI_IN)
MIDI_RST: R80.2, U28.38 (~RST)
unnamed: C29.1, J13.T
unnamed: C30.1, J14.T
unnamed: C30.2, C31.2, R52.1
unnamed: C100.2, R76.2
unnamed: C101.2, R77.2
unnamed: C42.2, C104.2, R63.2
unnamed: C45.2, C105.2, R64.2
unnamed: D6.2 (A), JP2.2 (B)
unnamed: D6.1 (K), Q2.1 (B), R58.1
unnamed: J12.A5 (CC1), R53.1
unnamed: J12.B5 (CC2), R48.1
unnamed: LS1.1 (-), Q2.2 (E)
unnamed: R51.2, R54.2, R55.1, U22.2 (+)
unnamed: C29.2, R47.1, R51.1, U22.3 (-)
unnamed: C38.1, U25.4 (CAPM)
unnamed: C38.2, U25.2 (CAPP)
unnamed: C43.2, C47.2, U25.18 (LDOO)
unnamed: R63.1, U25.6 (OUTL)
unnamed: R64.1, U25.7 (OUTR)
unnamed: C39.2, C41.2, U25.5 (VNEG)
unnamed: R61.2, U26.2 (ADC)
unnamed: R60.1, U26.3 (EN)
unnamed: R68.1, U26.17 (GPIO2)
unnamed: TP16.1, U26.19 (GPIO4)
unnamed: TP17.1, U26.20 (GPIO5)
unnamed: TP18.1, U26.6 (GPIO12)
unnamed: TP19.1, U26.5 (GPIO14)
unnamed: R66.2, U26.16 (GPIO15)
unnamed: R67.2, U26.4 (GPIO16)
unnamed: R76.1, U28.1 (AOUTL)
unnamed: R77.1, U28.2 (AOUTR)
unnamed: C96.2, C97.2, U28.34 (OUTVC12)
unnamed: C98.2, C99.2, U28.5 (VCM)
SND_L: C100.1, C104.1; also elsewhere on the board
SND_R: C101.1, C105.1; also elsewhere on the board
TAPE_IN: R56.2, U22.7; also elsewhere on the board
TAPE_OUT: R52.2; also elsewhere on the board
TP5: R80.1; also elsewhere on the board
TP6: R79.1; also elsewhere on the board
TP7: R78.1; also elsewhere on the board
UART_CTS: U26.7 (GPIO13); also elsewhere on the board
UART_RX: U26.22 (GPIO1/TXD); also elsewhere on the board
UART_TX: U26.21 (GPIO3/RXD); also elsewhere on the board
USB_D+: R50.2; also elsewhere on the board
USB_D-: R49.2; also elsewhere on the board
VCC: C33.1, C34.1, C46.1, F1.2, J15.1, U23.3 (VI), U24.3 (VI), U27.3 (VI); also elsewhere on the board
VCC1_2: C36.1, C49.1, R57.1, U24.2 (VO); also elsewhere on the board
VCC3_3: C32.1, C35.1, C48.1, C87.1, C102.2, C103.2, Q2.3 (C), R54.1, R56.1, R58.2, R59.1, U22.8 (V+), U23.2 (VO), U25.1 (CPVDD), U25.8 (AVDD), U25.20 (DVDD), U28.6 (VA33), U28.8 (VD33), U28.11 (VD33), U28.12 (~WR), U28.20 (VD33), U28.31 (VD33), U28.35 (VD33), U28.41 (VD33), U28.46 (VD33), U28.47 (XDIV); also elsewhere on the board
~ESP_BOOT: R65.1, U26.18 (GPIO0); also elsewhere on the board
~ESP_RESET: C44.1, R62.1, R67.1, U26.1 (~RST); also elsewhere on the board

Notes on the sheet:
MIDI Interconnection
Audio DAC
Power / USB
Wi-Fi
Beeper
MIDI
Tape In/Out
