andykarpov/karabas-go-pcb/karabas-go.kicad_pcb

## KiCad design karabas-go.kicad_pcb (continued)

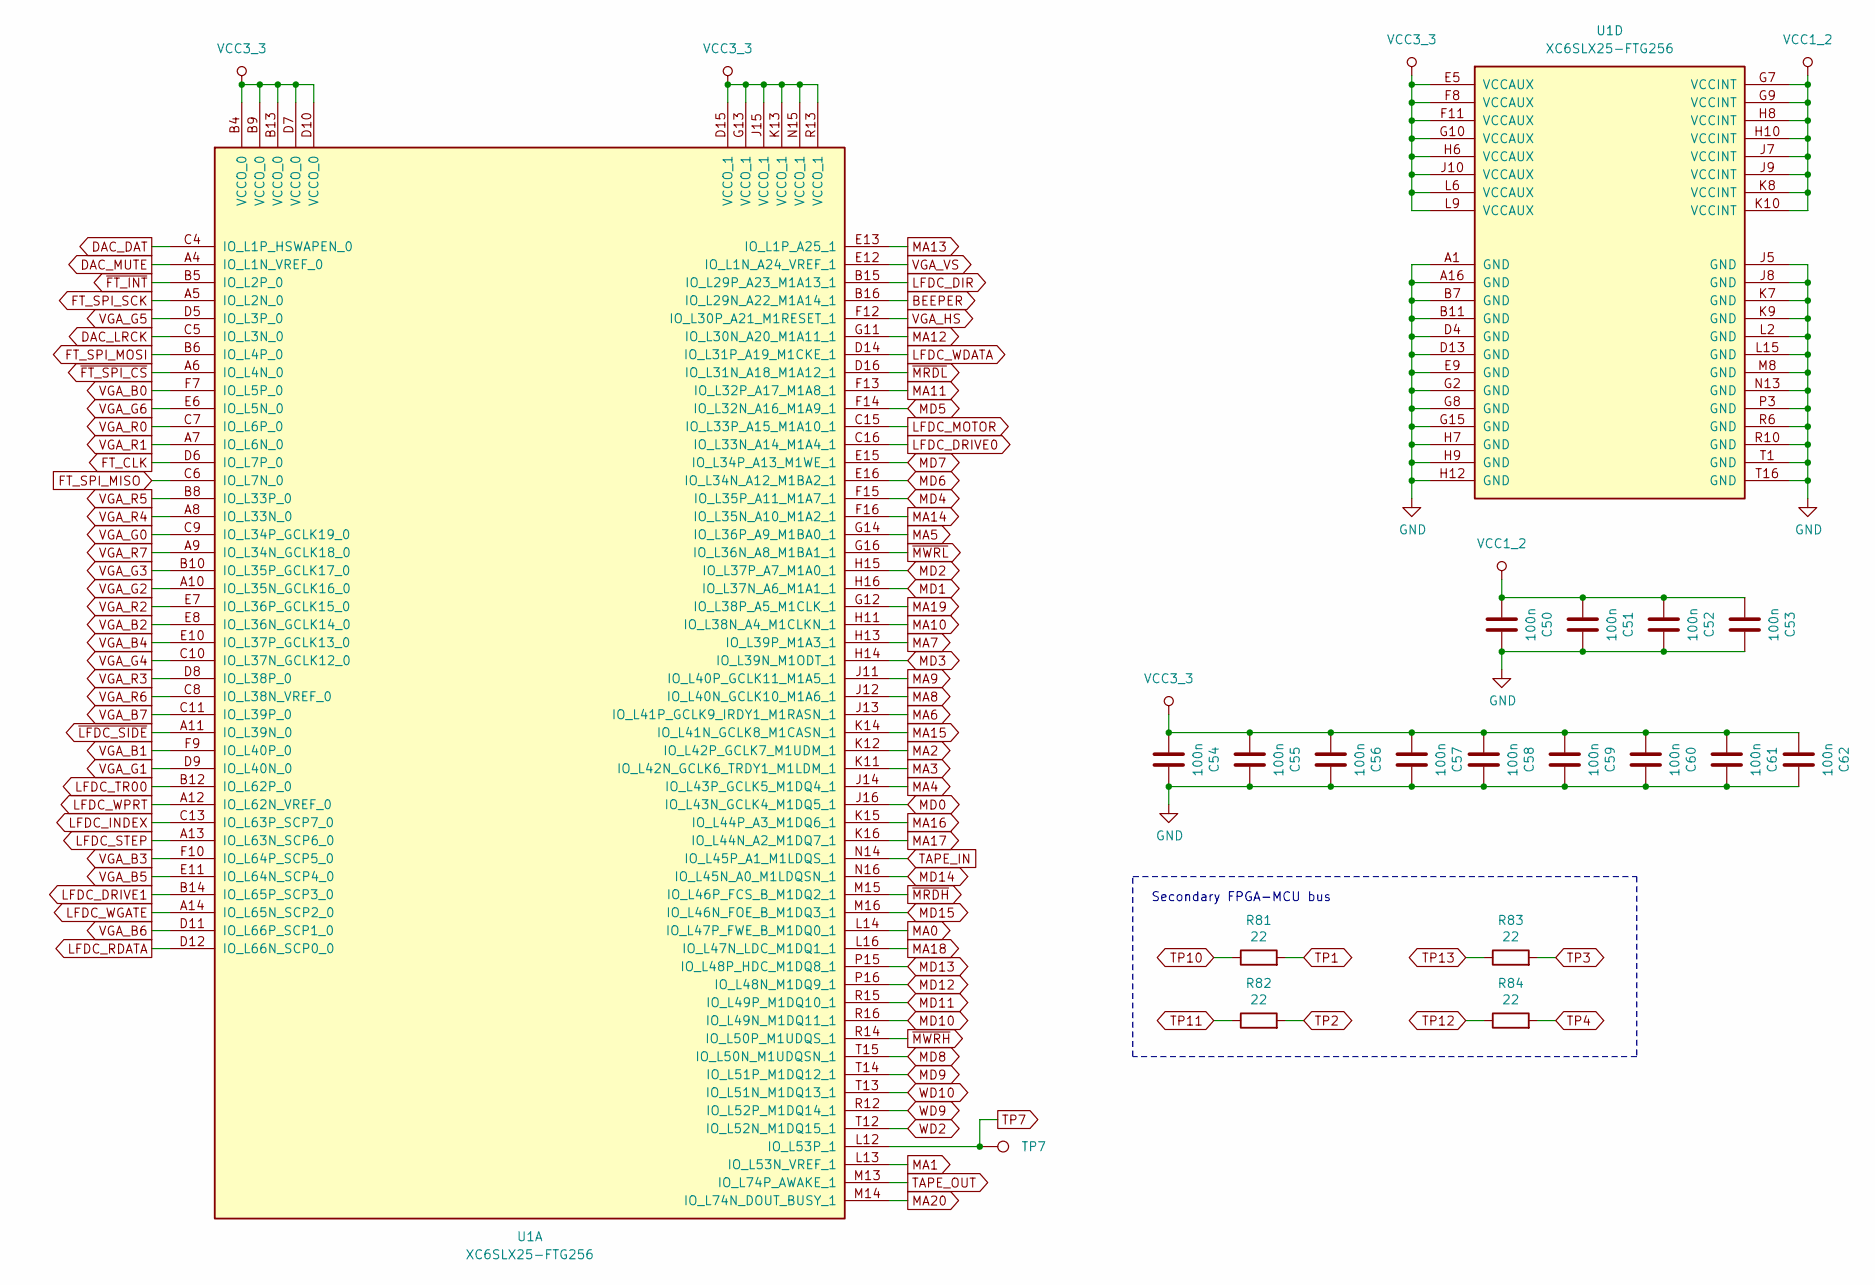
[picture p5: schematic fpga.kicad_sch, Karabas-Go]

Parts:
C50, C51, C52, C53: 100n; C_0603_1608Metric
C54, C55, C56, C57, C58, C59, C60, C61, C62: 100n; C_0805_2012Metric_Pad1.18x1.45mm_HandSolder
R81, R82, R83, R84: 22; R_0805_2012Metric_Pad1.20x1.40mm_HandSolder
TP7: TestPoint; TestPoint_Pad_D1.0mm
U1: XC6SLX25-FTG256; BGA-256_17.0x17.0mm_Layout16x16_P1.0mm_Ball0.5mm_Pad0.4mm_N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

Connections:
BEEPER: U1.B16 (IO_L29N_A22_M1A14_1); also elsewhere on the board
DAC_DAT: U1.C4 (IO_L1P_HSWAPEN_0); also elsewhere on the board
DAC_LRCK: U1.C5 (IO_L3N_0); also elsewhere on the board
DAC_MUTE: U1.A4 (IO_L1N_VREF_0); also elsewhere on the board
FT_CLK: U1.D6 (IO_L7P_0); also elsewhere on the board
FT_SPI_MISO: U1.C6 (IO_L7N_0); also elsewhere on the board
FT_SPI_MOSI: U1.B6 (IO_L4P_0); also elsewhere on the board
FT_SPI_SCK: U1.A5 (IO_L2N_0); also elsewhere on the board
GND: C50.2, C51.2, C52.2, C53.2, C54.2, C55.2, C56.2, C57.2, C58.2, C59.2, C60.2, C61.2, C62.2, U1.A1 (GND), U1.A16 (GND), U1.B7 (GND), U1.B11 (GND), U1.D4 (GND), U1.D13 (GND), U1.E9 (GND), U1.G2 (GND), U1.G8 (GND), U1.G15 (GND), U1.H7 (GND), U1.H9 (GND), U1.H12 (GND), U1.J5 (GND), U1.J8 (GND), U1.K7 (GND), U1.K9 (GND), U1.L2 (GND), U1.L15 (GND), U1.M8 (GND), U1.N13 (GND), U1.P3 (GND), U1.R6 (GND), U1.R10 (GND), U1.T1 (GND), U1.T16 (GND); also elsewhere on the board
LFDC_DIR: U1.B15 (IO_L29P_A23_M1A13_1); also elsewhere on the board
LFDC_DRIVE0: U1.C16 (IO_L33N_A14_M1A4_1); also elsewhere on the board
LFDC_DRIVE1: U1.B14 (IO_L65P_SCP3_0); also elsewhere on the board
LFDC_INDEX: U1.C13 (IO_L63P_SCP7_0); also elsewhere on the board
LFDC_MOTOR: U1.C15 (IO_L33P_A15_M1A10_1); also elsewhere on the board
LFDC_RDATA: U1.D12 (IO_L66N_SCP0_0); also elsewhere on the board
LFDC_STEP: U1.A13 (IO_L63N_SCP6_0); also elsewhere on the board
LFDC_TR00: U1.B12 (IO_L62P_0); also elsewhere on the board
LFDC_WDATA: U1.D14 (IO_L31P_A19_M1CKE_1); also elsewhere on the board
LFDC_WGATE: U1.A14 (IO_L65N_SCP2_0); also elsewhere on the board
LFDC_WPRT: U1.A12 (IO_L62N_VREF_0); also elsewhere on the board
MA0: U1.L14 (IO_L47P_FWE_B_M1DQ0_1); also elsewhere on the board
MA1: U1.L13 (IO_L53N_VREF_1); also elsewhere on the board
MA2: U1.K12 (IO_L42P_GCLK7_M1UDM_1); also elsewhere on the board
MA3: U1.K11 (IO_L42N_GCLK6_TRDY1_M1LDM_1); also elsewhere on the board
MA4: U1.J14 (IO_L43P_GCLK5_M1DQ4_1); also elsewhere on the board
MA5: U1.G14 (IO_L36P_A9_M1BA0_1); also elsewhere on the board
MA6: U1.J13 (IO_L41P_GCLK9_IRDY1_M1RASN_1); also elsewhere on the board
MA7: U1.H13 (IO_L39P_M1A3_1); also elsewhere on the board
MA8: U1.J12 (IO_L40N_GCLK10_M1A6_1); also elsewhere on the board
MA9: U1.J11 (IO_L40P_GCLK11_M1A5_1); also elsewhere on the board
MA10: U1.H11 (IO_L38N_A4_M1CLKN_1); also elsewhere on the board
MA11: U1.F13 (IO_L32P_A17_M1A8_1); also elsewhere on the board
MA12: U1.G11 (IO_L30N_A20_M1A11_1); also elsewhere on the board
MA13: U1.E13 (IO_L1P_A25_1); also elsewhere on the board
MA14: U1.F16 (IO_L35N_A10_M1A2_1); also elsewhere on the board
MA15: U1.K14 (IO_L41N_GCLK8_M1CASN_1); also elsewhere on the board
MA16: U1.K15 (IO_L44P_A3_M1DQ6_1); also elsewhere on the board
MA17: U1.K16 (IO_L44N_A2_M1DQ7_1); also elsewhere on the board
MA18: U1.L16 (IO_L47N_LDC_M1DQ1_1); also elsewhere on the board
MA19: U1.G12 (IO_L38P_A5_M1CLK_1); also elsewhere on the board
MA20: U1.M14 (IO_L74N_DOUT_BUSY_1); also elsewhere on the board
MD0: U1.J16 (IO_L43N_GCLK4_M1DQ5_1); also elsewhere on the board
MD1: U1.H16 (IO_L37N_A6_M1A1_1); also elsewhere on the board
MD2: U1.H15 (IO_L37P_A7_M1A0_1); also elsewhere on the board
MD3: U1.H14 (IO_L39N_M1ODT_1); also elsewhere on the board
MD4: U1.F15 (IO_L35P_A11_M1A7_1); also elsewhere on the board
MD5: U1.F14 (IO_L32N_A16_M1A9_1); also elsewhere on the board
MD6: U1.E16 (IO_L34N_A12_M1BA2_1); also elsewhere on the board
MD7: U1.E15 (IO_L34P_A13_M1WE_1); also elsewhere on the board
MD8: U1.T15 (IO_L50N_M1UDQSN_1); also elsewhere on the board
MD9: U1.T14 (IO_L51P_M1DQ12_1); also elsewhere on the board
MD10: U1.R16 (IO_L49N_M1DQ11_1); also elsewhere on the board
MD11: U1.R15 (IO_L49P_M1DQ10_1); also elsewhere on the board
MD12: U1.P16 (IO_L48N_M1DQ9_1); also elsewhere on the board
MD13: U1.P15 (IO_L48P_HDC_M1DQ8_1); also elsewhere on the board
MD14: U1.N16 (IO_L45N_A0_M1LDQSN_1); also elsewhere on the board
MD15: U1.M16 (IO_L46N_FOE_B_M1DQ3_1); also elsewhere on the board
TAPE_IN: U1.N14 (IO_L45P_A1_M1LDQS_1); also elsewhere on the board
TAPE_OUT: U1.M13 (IO_L74P_AWAKE_1); also elsewhere on the board
TP1: R81.2; also elsewhere on the board
TP2: R82.2; also elsewhere on the board
TP3: R83.2; also elsewhere on the board
TP4: R84.2; also elsewhere on the board
TP7: TP7.1, U1.L12 (IO_L53P_1); also elsewhere on the board
TP10: R81.1; also elsewhere on the board
TP11: R82.1; also elsewhere on the board
TP12: R84.1; also elsewhere on the board
TP13: R83.1; also elsewhere on the board
VCC1_2: C50.1, C51.1, C52.1, C53.1, U1.G7 (VCCINT), U1.G9 (VCCINT), U1.H8 (VCCINT), U1.H10 (VCCINT), U1.J7 (VCCINT), U1.J9 (VCCINT), U1.K8 (VCCINT), U1.K10 (VCCINT); also elsewhere on the board
VCC3_3: C54.1, C55.1, C56.1, C57.1, C58.1, C59.1, C60.1, C61.1, C62.1, U1.B4 (VCCO_0), U1.B9 (VCCO_0), U1.B13 (VCCO_0), U1.D7 (VCCO_0), U1.D10 (VCCO_0), U1.D15 (VCCO_1), U1.E5 (VCCAUX), U1.F8 (VCCAUX), U1.F11 (VCCAUX), U1.G10 (VCCAUX), U1.G13 (VCCO_1), U1.H6 (VCCAUX), U1.J10 (VCCAUX), U1.J15 (VCCO_1), U1.K13 (VCCO_1), U1.L6 (VCCAUX), U1.L9 (VCCAUX), U1.N15 (VCCO_1), U1.R13 (VCCO_1); also elsewhere on the board
VGA_B0: U1.F7 (IO_L5P_0); also elsewhere on the board
VGA_B1: U1.F9 (IO_L40P_0); also elsewhere on the board
VGA_B2: U1.E8 (IO_L36N_GCLK14_0); also elsewhere on the board
VGA_B3: U1.F10 (IO_L64P_SCP5_0); also elsewhere on the board
VGA_B4: U1.E10 (IO_L37P_GCLK13_0); also elsewhere on the board
VGA_B5: U1.E11 (IO_L64N_SCP4_0); also elsewhere on the board
VGA_B6: U1.D11 (IO_L66P_SCP1_0); also elsewhere on the board
VGA_B7: U1.C11 (IO_L39P_0); also elsewhere on the board
VGA_G0: U1.C9 (IO_L34P_GCLK19_0); also elsewhere on the board
VGA_G1: U1.D9 (IO_L40N_0); also elsewhere on the board
VGA_G2: U1.A10 (IO_L35N_GCLK16_0); also elsewhere on the board
VGA_G3: U1.B10 (IO_L35P_GCLK17_0); also elsewhere on the board
VGA_G4: U1.C10 (IO_L37N_GCLK12_0); also elsewhere on the board
VGA_G5: U1.D5 (IO_L3P_0); also elsewhere on the board
VGA_G6: U1.E6 (IO_L5N_0); also elsewhere on the board
VGA_HS: U1.F12 (IO_L30P_A21_M1RESET_1); also elsewhere on the board
VGA_R0: U1.C7 (IO_L6P_0); also elsewhere on the board
VGA_R1: U1.A7 (IO_L6N_0); also elsewhere on the board
VGA_R2: U1.E7 (IO_L36P_GCLK15_0); also elsewhere on the board
VGA_R3: U1.D8 (IO_L38P_0); also elsewhere on the board
VGA_R4: U1.A8 (IO_L33N_0); also elsewhere on the board
VGA_R5: U1.B8 (IO_L33P_0); also elsewhere on the board
VGA_R6: U1.C8 (IO_L38N_VREF_0); also elsewhere on the board
VGA_R7: U1.A9 (IO_L34N_GCLK18_0); also elsewhere on the board
VGA_VS: U1.E12 (IO_L1N_A24_VREF_1); also elsewhere on the board
WD2: U1.T12 (IO_L52N_M1DQ15_1); also elsewhere on the board
WD9: U1.R12 (IO_L52P_M1DQ14_1); also elsewhere on the board
WD10: U1.T13 (IO_L51N_M1DQ13_1); also elsewhere on the board
~FT_INT: U1.B5 (IO_L2P_0); also elsewhere on the board
~FT_SPI_CS: U1.A6 (IO_L4N_0); also elsewhere on the board
~LFDC_SIDE: U1.A11 (IO_L39N_0); also elsewhere on the board
~MRDH: U1.M15 (IO_L46P_FCS_B_M1DQ2_1); also elsewhere on the board
~MRDL: U1.D16 (IO_L31N_A18_M1A12_1); also elsewhere on the board
~MWRH: U1.R14 (IO_L50P_M1UDQS_1); also elsewhere on the board
~MWRL: U1.G16 (IO_L36N_A8_M1BA1_1); also elsewhere on the board

Notes on the sheet:
Secondary FPGA-MCU bus

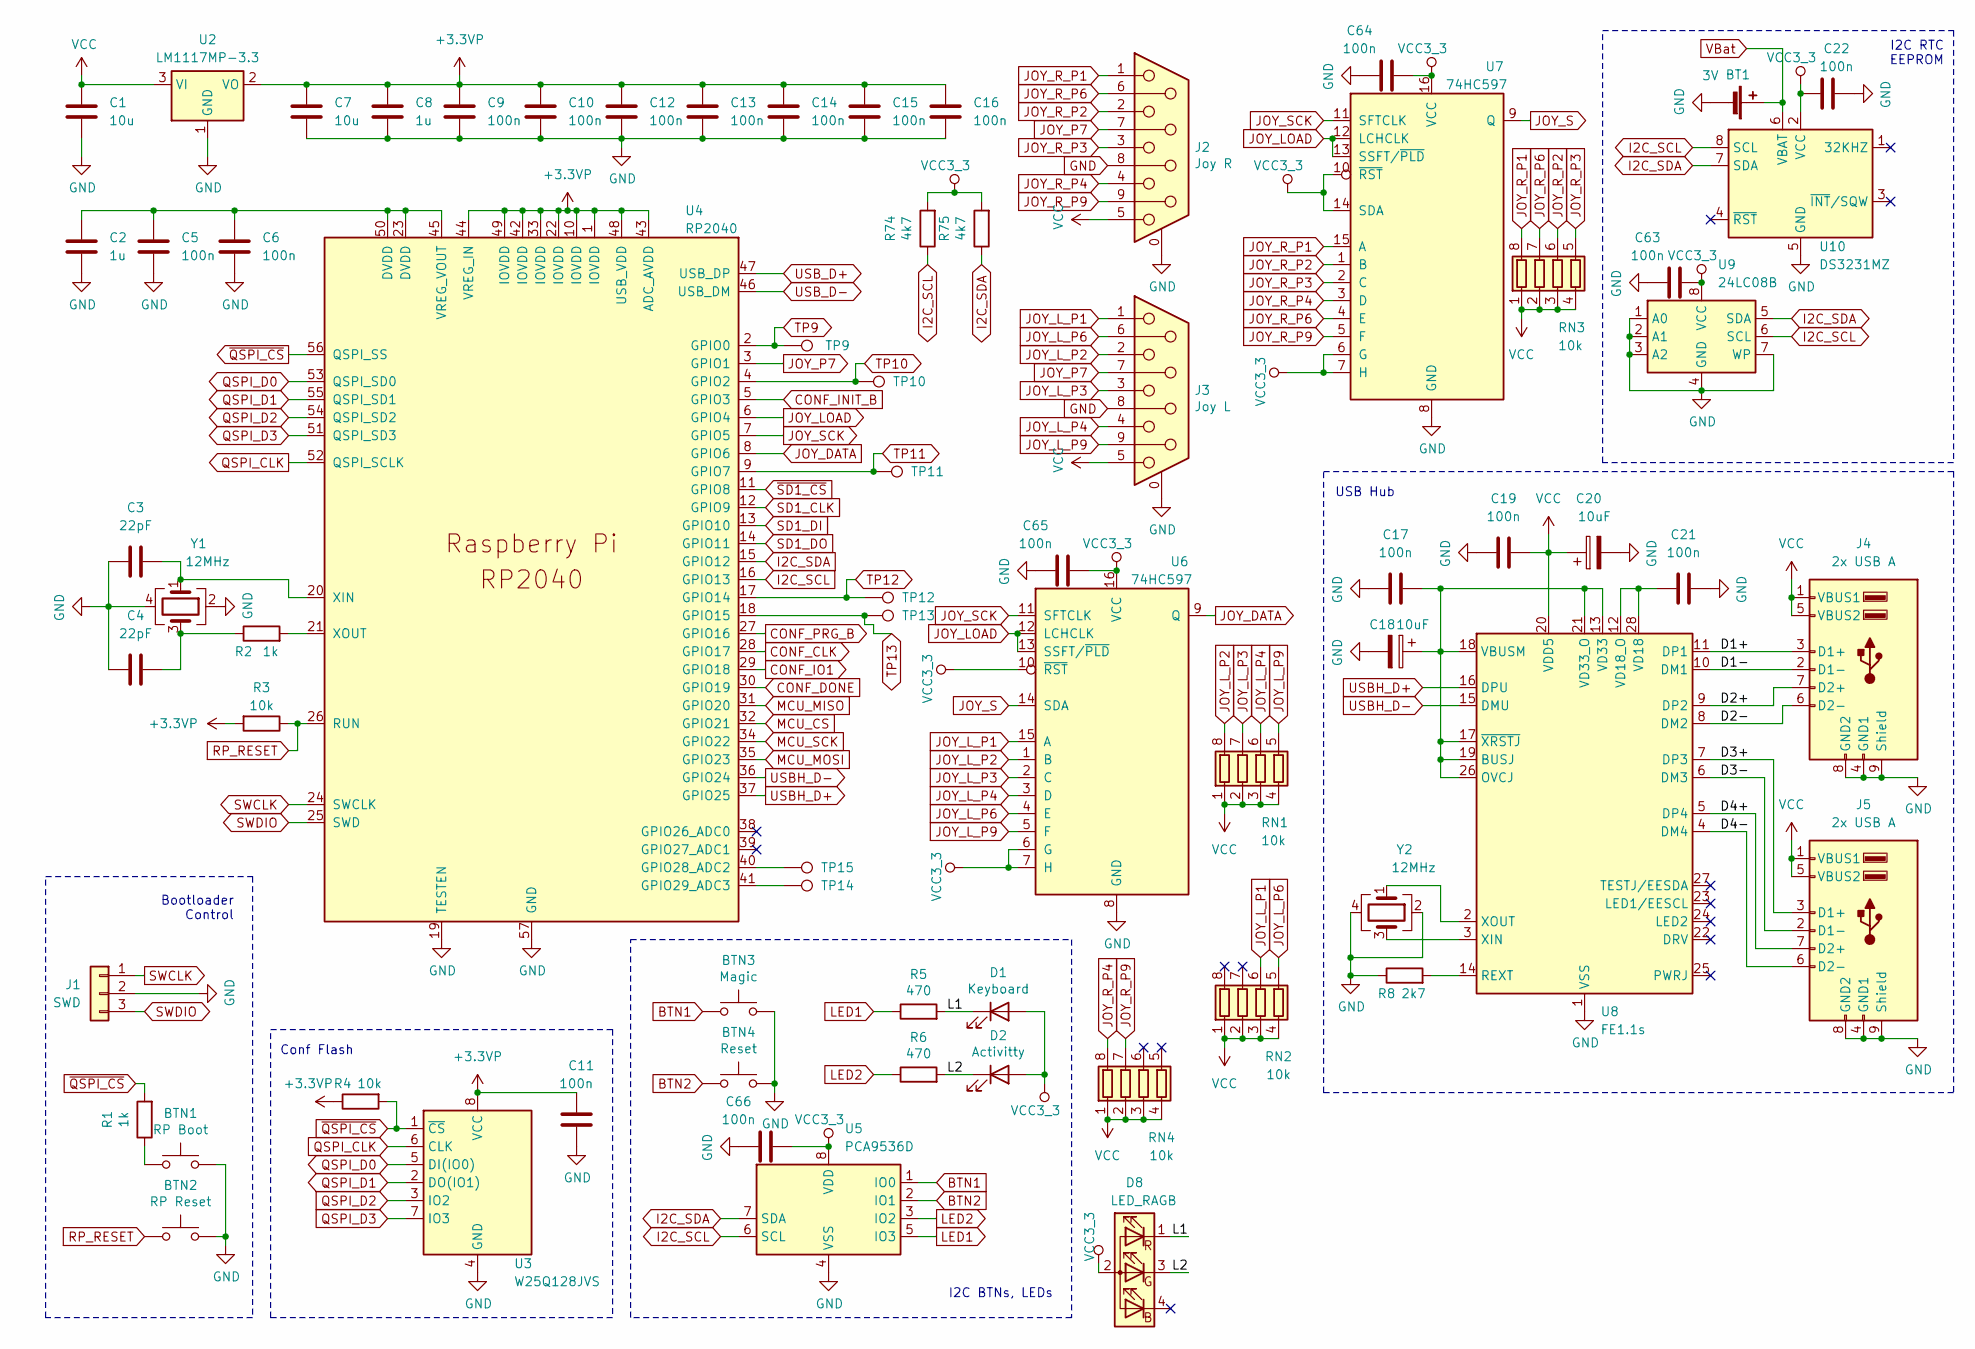
[picture p6: schematic rp2040.kicad_sch, Karabas-Go]

Parts:
BT1: 3V; BAT_BS-7-BLUE
BTN1: RP Boot; SW_SPST_PTS810_handsoldering
BTN2: RP Reset; SW_SPST_PTS810_handsoldering
BTN3: Magic; SW_Tactile_SPST_Angled_PTS645Vx58-2LFS
BTN4: Reset; SW_Tactile_SPST_Angled_PTS645Vx58-2LFS
C1, C7: 10u; C_0805_2012Metric_Pad1.18x1.45mm_HandSolder
C2, C8: 1u; C_0805_2012Metric_Pad1.18x1.45mm_HandSolder
C3, C4: 22pF; C_0805_2012Metric_Pad1.18x1.45mm_HandSolder
C5, C6, C9, C10, C11, C12, C13, C14, C15, C16, C17, C19, C21, C22, C63, C64, C65, C66: 100n; C_0805_2012Metric_Pad1.18x1.45mm_HandSolder
C18, C20: 10uF; CP_EIA-7343-31_Kemet-D-uni
D1: Keyboard; LED_0805_2012Metric_Pad1.15x1.40mm_HandSolder
D2: Activitty; LED_0805_2012Metric_Pad1.15x1.40mm_HandSolder
D8: LED_RAGB; LED_D5.0mm-4_RGB_tiny
J1: SWD; PinHeader_1x03_P2.54mm_Vertical
J2: Joy R; DSUB-9_Male_Horizontal_P2.77x2.84mm_EdgePinOffset7.70mm_Hou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
J3: Joy L; DSUB-9_Male_Horizontal_P2.77x2.84mm_EdgePinOffset7.70mm_Hou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
J4, J5: 2x USB A; USB_A_Wuerth_61400826021_Horizontal_Stacked_oval
R1, R2: 1k; R_0805_2012Metric_Pad1.20x1.40mm_HandSolder
R3, R4: 10k; R_0805_2012Metric_Pad1.20x1.40mm_HandSolder
R5, R6: 470; R_0805_2012Metric_Pad1.20x1.40mm_HandSolder
R8: 2k7; R_0805_2012Metric_Pad1.20x1.40mm_HandSolder
R74, R75: 4k7; R_0805_2012Metric_Pad1.20x1.40mm_HandSolder
RN1, RN2, RN3, RN4: 10k; R_Array_Convex_4x0603
TP9, TP10, TP11, TP12, TP13, TP14, TP15: TestPoint; TestPoint_Pad_D1.0mm
U2: LM1117MP-3.3; SOT-223-3_TabPin2
U3: W25Q128JVS; SOIC-8_5.23x5.23mm_P1.27mm
U4: RP2040; RP2040-QFN-56
U5: PCA9536D; SOIC-8_3.9x4.9mm_P1.27mm
U6, U7: 74HC597; SO-16_3.9x9.9mm_P1.27mm
U8: FE1.1s; SSOP-28_3.9x9.9mm_P0.635mm-long
U9: 24LC08B; SO-8_3.9x4.9mm_P1.27mm
U10: DS3231MZ; SOIC-8_3.9x4.9mm_P1.27mm
Y1, Y2: 12MHz; Crystal_SMD_3225-4Pin_3.2x2.5mm_HandSoldering

Connections:
+3.3VP: C7.1, C8.1, C9.1, C10.1, C11.2, C12.1, C13.1, C14.1, C15.1, C16.1, R3.2, R4.1, U2.2 (VO), U3.8 (VCC), U4.1 (IOVDD), U4.10 (IOVDD), U4.22 (IOVDD), U4.33 (IOVDD), U4.42 (IOVDD), U4.43 (ADC_AVDD), U4.44 (VREG_IN), U4.48 (USB_VDD), U4.49 (IOVDD)
/RP2040/D1+: J4.3 (D1+), U8.11 (DP1)
/RP2040/D1-: J4.2 (D1-), U8.10 (DM1)
/RP2040/D2+: J4.7 (D2+), U8.9 (DP2)
/RP2040/D2-: J4.6 (D2-), U8.8 (DM2)
/RP2040/D3+: J5.3 (D1+), U8.7 (DP3)
/RP2040/D3-: J5.2 (D1-), U8.6 (DM3)
/RP2040/D4+: J5.7 (D2+), U8.5 (DP4)
/RP2040/D4-: J5.6 (D2-), U8.4 (DM4)
/RP2040/L1: D1.1 (K), D8.1 (RK), R5.2
/RP2040/L2: D2.1 (K), D8.3 (GK), R6.2
BTN1: BTN3.1, U5.1 (IO0)
BTN2: BTN4.1, U5.2 (IO1)
CONF_CLK: U4.28 (GPIO17); also elsewhere on the board
CONF_DONE: U4.30 (GPIO19); also elsewhere on the board
CONF_INIT_B: U4.5 (GPIO3); also elsewhere on the board
CONF_IO1: U4.29 (GPIO18); also elsewhere on the board
CONF_PRG_B: U4.27 (GPIO16); also elsewhere on the board
GND: BT1.2 (-), BTN1.2, BTN2.2, BTN3.2, BTN4.2, C1.2, C2.2, C3.2, C4.2, C5.2, C6.2, C7.2, C8.2, C9.2, C10.2, C11.1, C12.2, C13.2, C14.2, C15.2, C16.2, C17.2, C18.2, C19.2, C20.2, C21.1, C22.2, C63.2, C64.2, C65.2, C66.2, J1.2, J2.0 (PAD), J2.8, J3.0 (PAD), J3.8, J4.4 (GND1), J4.8 (GND2), J4.9 (Shield), J5.4 (GND1), J5.8 (GND2), J5.9 (Shield), R8.1, U2.1 (GND), U3.4 (GND), U4.19 (TESTEN), U4.57 (GND), U5.4 (VSS), U6.8 (GND), U7.8 (GND), U8.1 (VSS), U9.1 (A0), U9.2 (A1), U9.3 (A2), U9.4 (GND), U9.7 (WP), U10.5 (GND), Y1.2, Y1.4, Y2.2, Y2.4; also elsewhere on the board
I2C_SCL: R74.1, U4.16 (GPIO13), U5.6 (SCL), U9.6 (SCL), U10.8 (SCL); also elsewhere on the board
I2C_SDA: R75.1, U4.15 (GPIO12), U5.7 (SDA), U9.5 (SDA), U10.7 (SDA); also elsewhere on the board
JOY_DATA: U4.8 (GPIO6), U6.9 (Q)
JOY_LOAD: U4.6 (GPIO4), U6.12 (LCHCLK), U6.13 (SSFT/~PLD), U7.12 (LCHCLK), U7.13 (SSFT/~PLD)
JOY_L_P1: J3.1, RN2.6 (R3.2), U6.15 (A)
JOY_L_P2: J3.2, RN1.8 (R1.2), U6.1 (B)
JOY_L_P3: J3.3, RN1.7 (R2.2), U6.2 (C)
JOY_L_P4: J3.4, RN1.6 (R3.2), U6.3 (D)
JOY_L_P6: J3.6, RN2.5 (R4.2), U6.4 (E)
JOY_L_P9: J3.9, RN1.5 (R4.2), U6.5 (F)
JOY_P7: J2.7, J3.7, U4.3 (GPIO1)
JOY_R_P1: J2.1, RN3.8 (R1.2), U7.15 (A)
JOY_R_P2: J2.2, RN3.6 (R3.2), U7.1 (B)
JOY_R_P3: J2.3, RN3.5 (R4.2), U7.2 (C)
JOY_R_P4: J2.4, RN4.8 (R1.2), U7.3 (D)
JOY_R_P6: J2.6, RN3.7 (R2.2), U7.4 (E)
JOY_R_P9: J2.9, RN4.7 (R2.2), U7.5 (F)
JOY_S: U6.14 (SDA), U7.9 (Q)
JOY_SCK: U4.7 (GPIO5), U6.11 (SFTCLK), U7.11 (SFTCLK)
LED1: R5.1, U5.5 (IO3)
LED2: R6.1, U5.3 (IO2)
MCU_CS: U4.32 (GPIO21); also elsewhere on the board
MCU_MISO: U4.31 (GPIO20); also elsewhere on the board
MCU_MOSI: U4.35 (GPIO23); also elsewhere on the board
MCU_SCK: U4.34 (GPIO22); also elsewhere on the board
unnamed: BTN1.1, R1.1
unnamed: C4.1, R2.1, Y1.3
unnamed: TP15.1, U4.40 (GPIO28_ADC2)
unnamed: TP14.1, U4.41 (GPIO29_ADC3)
unnamed: C2.1, C5.1, C6.1, U4.23 (DVDD), U4.45 (VREG_VOUT), U4.50 (DVDD)
unnamed: C3.1, U4.20 (XIN), Y1.1
unnamed: R2.2, U4.21 (XOUT)
unnamed: C17.1, C18.1, U8.13 (VD33), U8.17 (~XRSTJ), U8.18 (VBUSM), U8.19 (BUSJ), U8.21 (VD33_O), U8.26 (OVCJ)
unnamed: R8.2, U8.14 (REXT)
unnamed: C21.2, U8.12 (VD18_O), U8.28 (VD18)
unnamed: U8.3 (XIN), Y2.3
unnamed: U8.2 (XOUT), Y2.1
QSPI_CLK: U3.6 (CLK), U4.52 (QSPI_SCLK)
QSPI_D0: U3.5 (DI(IO0)), U4.53 (QSPI_SD0)
QSPI_D1: U3.2 (DO(IO1)), U4.55 (QSPI_SD1)
QSPI_D2: U3.3 (IO2), U4.54 (QSPI_SD2)
QSPI_D3: U3.7 (IO3), U4.51 (QSPI_SD3)
RP_RESET: BTN2.1, R3.1, U4.26 (RUN)
SD1_CLK: U4.12 (GPIO9); also elsewhere on the board
SD1_DI: U4.13 (GPIO10); also elsewhere on the board
SD1_DO: U4.14 (GPIO11); also elsewhere on the board
SWCLK: J1.1, U4.24 (SWCLK)
SWDIO: J1.3, U4.25 (SWD)
TP9: TP9.1, U4.2 (GPIO0); also elsewhere on the board
TP10: TP10.1, U4.4 (GPIO2); also elsewhere on the board
TP11: TP11.1, U4.9 (GPIO7); also elsewhere on the board
TP12: TP12.1, U4.17 (GPIO14); also elsewhere on the board
TP13: TP13.1, U4.18 (GPIO15); also elsewhere on the board
USBH_D+: U4.37 (GPIO25), U8.16 (DPU)
USBH_D-: U4.36 (GPIO24), U8.15 (DMU)
USB_D+: U4.47 (USB_DP); also elsewhere on the board
USB_D-: U4.46 (USB_DM); also elsewhere on the board
VBat: BT1.1 (+), U10.6 (VBAT); also elsewhere on the board
VCC: C1.1, C19.1, C20.1, J2.5, J3.5, J4.1 (VBUS1), J4.5 (VBUS2), J5.1 (VBUS1), J5.5 (VBUS2), RN1.1 (R1.1), RN1.2 (R2.1), RN1.3 (R3.1), RN1.4 (R4.1), RN2.1 (R1.1), RN2.2 (R2.1), RN2.3 (R3.1), RN2.4 (R4.1), RN3.1 (R1.1), RN3.2 (R2.1), RN3.3 (R3.1), RN3.4 (R4.1), RN4.1 (R1.1), RN4.2 (R2.1), RN4.3 (R3.1), RN4.4 (R4.1), U2.3 (VI), U8.20 (VDD5); also elsewhere on the board
VCC3_3: C22.1, C63.1, C64.1, C65.1, C66.1, D1.2 (A), D2.2 (A), D8.2 (A), R74.2, R75.2, U5.8 (VDD), U6.6 (G), U6.7 (H), U6.10 (~RST), U6.16 (VCC), U7.6 (G), U7.7 (H), U7.10 (~RST), U7.14 (SDA), U7.16 (VCC), U9.8 (VCC), U10.2 (VCC); also elsewhere on the board
~QSPI_CS: R1.2, R4.2, U3.1 (~CS), U4.56 (QSPI_SS)
~SD1_CS: U4.11 (GPIO8); also elsewhere on the board

Notes on the sheet:
Conf Flash
Bootloader Control
I2C RTC EEPROM
I2C BTNs, LEDs
USB Hub

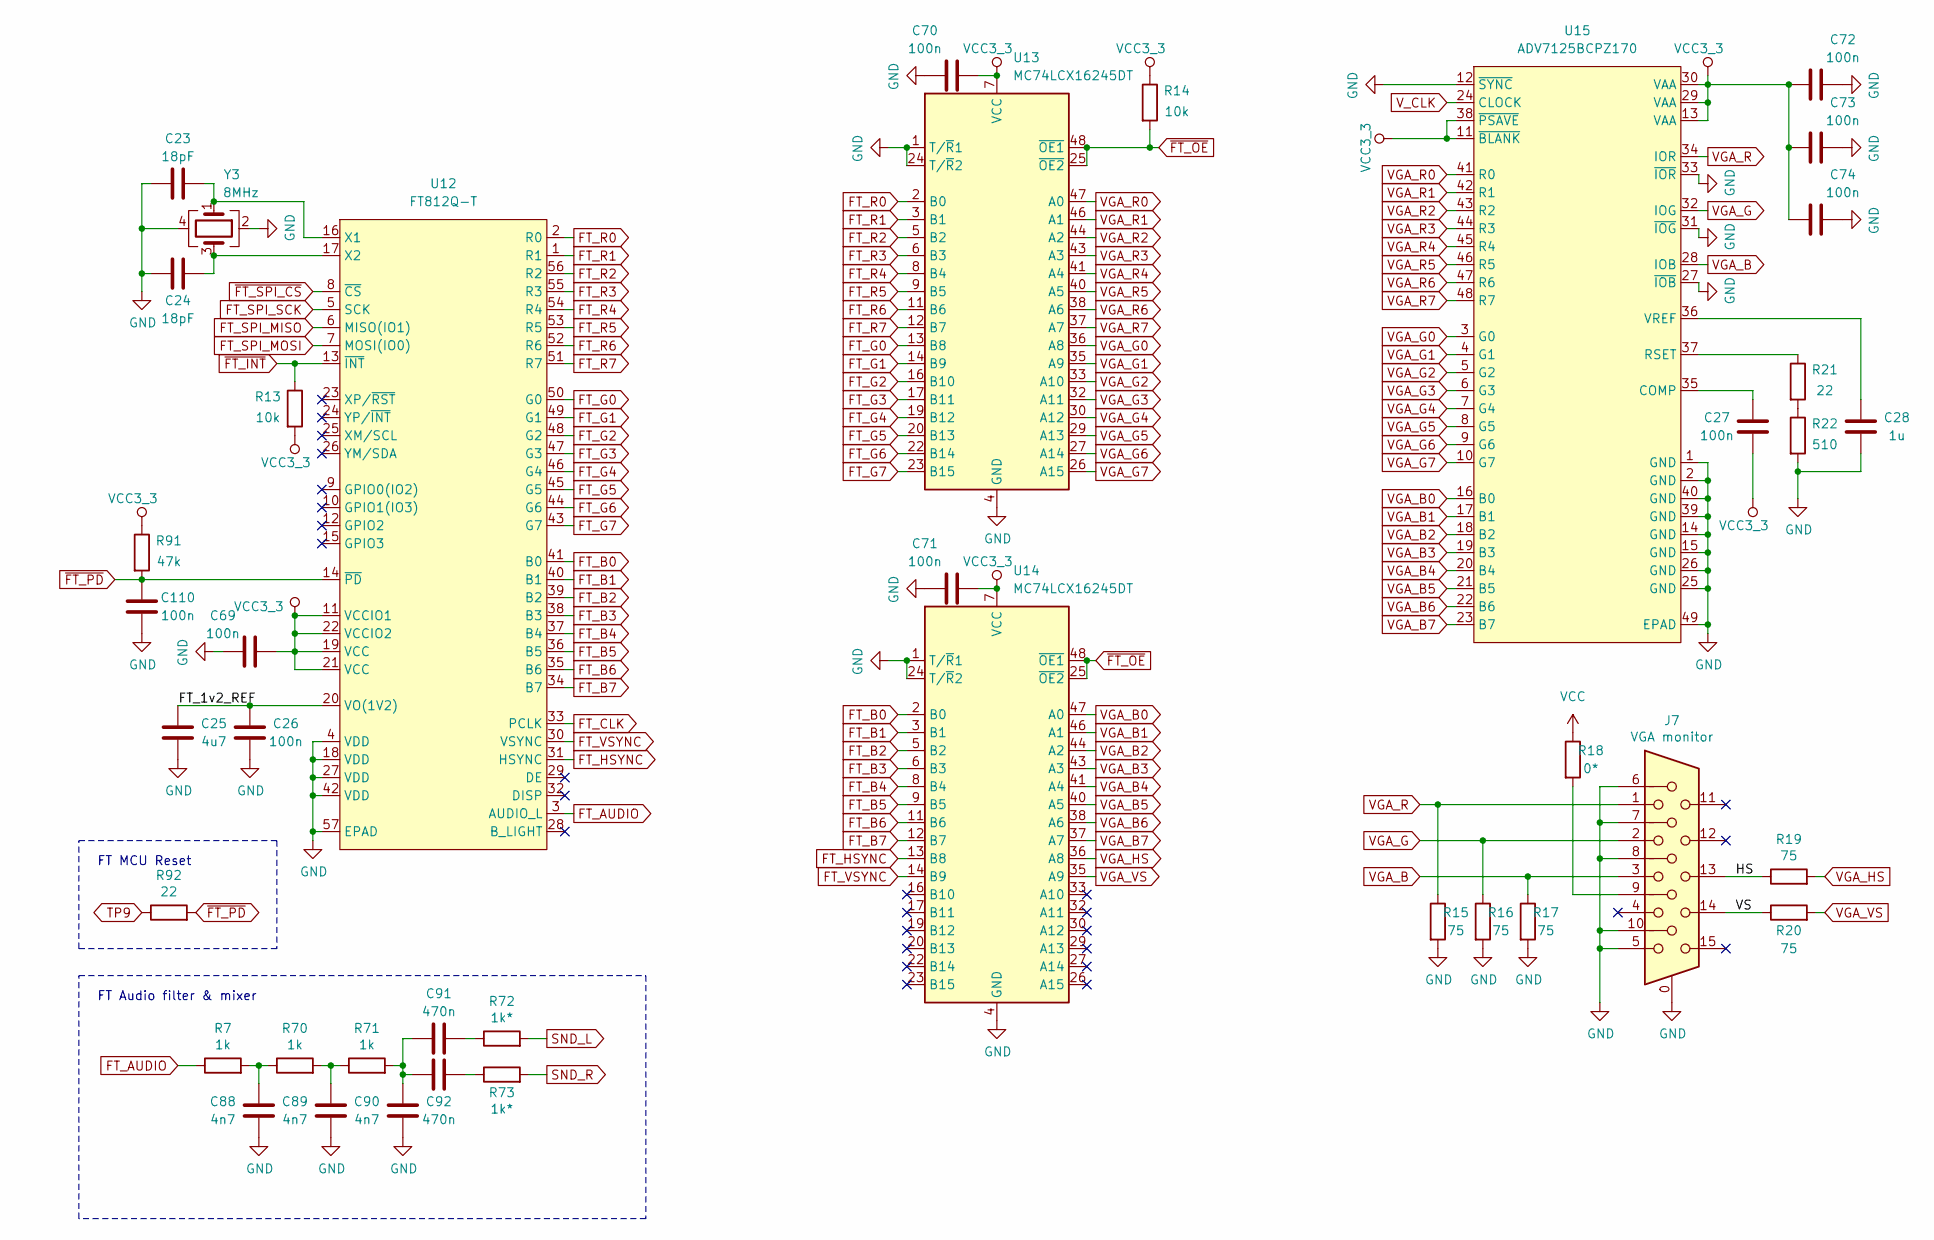
[picture p7: schematic vga.kicad_sch, Karabas-Go]

Parts:
C23, C24: 18pF; C_0805_2012Metric_Pad1.18x1.45mm_HandSolder
C25: 4u7; CP_EIA-3216-18_Kemet-A_Pad1.58x1.35mm_HandSolder
C26, C27, C69, C70, C71, C72, C73, C74, C110: 100n; C_0805_2012Metric_Pad1.18x1.45mm_HandSolder
C28: 1u; C_0805_2012Metric_Pad1.18x1.45mm_HandSolder
C88, C89, C90: 4n7; C_0805_2012Metric_Pad1.18x1.45mm_HandSolder
C91, C92: 470n; C_0805_2012Metric_Pad1.18x1.45mm_HandSolder
J7: VGA monitor; DSUB-15-HD_Female_Horizontal_P2.29x1.98mm_EdgePinOffset3.03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
R7, R70, R71: 1k; R_0805_2012Metric_Pad1.20x1.40mm_HandSolder
R13, R14: 10k; R_0805_2012Metric_Pad1.20x1.40mm_HandSolder
R15, R16, R17, R19, R20: 75; R_0805_2012Metric_Pad1.20x1.40mm_HandSolder
R18: 0*; R_0805_2012Metric_Pad1.20x1.40mm_HandSolder
R21, R92: 22; R_0805_2012Metric_Pad1.20x1.40mm_HandSolder
R22: 510; R_0805_2012Metric_Pad1.20x1.40mm_HandSolder
R72, R73: 1k*; R_0805_2012Metric_Pad1.20x1.40mm_HandSolder
R91: 47k; R_0805_2012Metric_Pad1.20x1.40mm_HandSolder
U12: FT812Q-T; QFN-56-1EP_8x8mm_P0.5mm_EP5.9x5.9mm_ThermalVias
U13, U14: MC74LCX16245DT; TSSOP-48_6.1x12.5mm_P0.5mm
U15: ADV7125BCPZ170; QFN-48-1EP_7x7mm_P0.5mm_EP5.1x5.1mm_ThermalVias_plus_QFP-48
Y3: 8MHz; Crystal_SMD_3225-4Pin_3.2x2.5mm_HandSoldering

Connections:
/VGA/FT_1v2_REF: C25.1, C26.1, U12.20 (VO(1V2))
/VGA/HS: J7.13, R19.1
/VGA/VS: J7.14, R20.1
FT_AUDIO: R7.1, U12.3 (AUDIO_L)
FT_B0: U12.41 (B0), U14.2 (B0)
FT_B1: U12.40 (B1), U14.3 (B1)
FT_B2: U12.39 (B2), U14.5 (B2)
FT_B3: U12.38 (B3), U14.6 (B3)
FT_B4: U12.37 (B4), U14.8 (B4)
FT_B5: U12.36 (B5), U14.9 (B5)
FT_B6: U12.35 (B6), U14.11 (B6)
FT_B7: U12.34 (B7), U14.12 (B7)
FT_CLK: U12.33 (PCLK); also elsewhere on the board
FT_G0: U12.50 (G0), U13.13 (B8)
FT_G1: U12.49 (G1), U13.14 (B9)
FT_G2: U12.48 (G2), U13.16 (B10)
FT_G3: U12.47 (G3), U13.17 (B11)
FT_G4: U12.46 (G4), U13.19 (B12)
FT_G5: U12.45 (G5), U13.20 (B13)
FT_G6: U12.44 (G6), U13.22 (B14)
FT_G7: U12.43 (G7), U13.23 (B15)
FT_HSYNC: U12.31 (HSYNC), U14.13 (B8)
FT_R0: U12.2 (R0), U13.2 (B0)
FT_R1: U12.1 (R1), U13.3 (B1)
FT_R2: U12.56 (R2), U13.5 (B2)
FT_R3: U12.55 (R3), U13.6 (B3)
FT_R4: U12.54 (R4), U13.8 (B4)
FT_R5: U12.53 (R5), U13.9 (B5)
FT_R6: U12.52 (R6), U13.11 (B6)
FT_R7: U12.51 (R7), U13.12 (B7)
FT_SPI_MISO: U12.6 (MISO(IO1)); also elsewhere on the board
FT_SPI_MOSI: U12.7 (MOSI(IO0)); also elsewhere on the board
FT_SPI_SCK: U12.5 (SCK); also elsewhere on the board
FT_VSYNC: U12.30 (VSYNC), U14.14 (B9)
GND: C23.2, C24.2, C25.2, C26.2, C28.2, C69.2, C70.2, C71.2, C72.2, C73.2, C74.2, C88.2, C89.2, C90.2, C110.2, J7.0, J7.5, J7.6, J7.7, J7.8, J7.10, R15.2, R16.2, R17.2, R22.2, U12.4 (VDD), U12.18 (VDD), U12.27 (VDD), U12.42 (VDD), U12.57 (EPAD), U13.1 (T/~R1), U13.4 (GND), U13.10 (GND), U13.15 (GND), U13.21 (GND), U13.24 (T/~R2), U13.28 (GND), U13.34 (GND), U13.39 (GND), U13.45 (GND), U14.1 (T/~R1), U14.4 (GND), U14.10 (GND), U14.15 (GND), U14.21 (GND), U14.24 (T/~R2), U14.28 (GND), U14.34 (GND), U14.39 (GND), U14.45 (GND), U15.1 (GND), U15.2 (GND), U15.12 (~SYNC), U15.14 (GND), U15.15 (GND), U15.25 (GND), U15.26 (GND), U15.27 (~IOB), U15.31 (~IOG), U15.33 (~IOR), U15.39 (GND), U15.40 (GND), U15.49 (EPAD), Y3.2, Y3.4; also elsewhere on the board
unnamed: C88.1, R7.2, R70.1
unnamed: C89.1, R70.2, R71.1
unnamed: C90.1, C91.2, C92.2, R71.2
unnamed: C91.1, R72.1
unnamed: C92.1, R73.1
unnamed: J7.9, R18.2
unnamed: R21.2, R22.1
unnamed: C23.1, U12.16 (X1), Y3.1
unnamed: C24.1, U12.17 (X2), Y3.3
unnamed: C27.1, U15.35 (COMP)
unnamed: R21.1, U15.37 (RSET)
unnamed: C28.1, U15.36 (VREF)
SND_L: R72.2; also elsewhere on the board
SND_R: R73.2; also elsewhere on the board
TP9: R92.1; also elsewhere on the board
VCC: R18.1; also elsewhere on the board
VCC3_3: C27.2, C69.1, C70.1, C71.1, C72.1, C73.1, C74.1, R13.2, R14.1, R91.1, U12.11 (VCCIO1), U12.19 (VCC), U12.21 (VCC), U12.22 (VCCIO2), U13.7 (VCC), U13.18 (VCC), U13.31 (VCC), U13.42 (VCC), U14.7 (VCC), U14.18 (VCC), U14.31 (VCC), U14.42 (VCC), U15.11 (~BLANK), U15.13 (VAA), U15.29 (VAA), U15.30 (VAA), U15.38 (~PSAVE); also elsewhere on the board
VGA_B: J7.3, R17.1, U15.28 (IOB)
VGA_B0: U14.47 (A0), U15.16 (B0); also elsewhere on the board
VGA_B1: U14.46 (A1), U15.17 (B1); also elsewhere on the board
VGA_B2: U14.44 (A2), U15.18 (B2); also elsewhere on the board
VGA_B3: U14.43 (A3), U15.19 (B3); also elsewhere on the board
VGA_B4: U14.41 (A4), U15.20 (B4); also elsewhere on the board
VGA_B5: U14.40 (A5), U15.21 (B5); also elsewhere on the board
VGA_B6: U14.38 (A6), U15.22 (B6); also elsewhere on the board
VGA_B7: U14.37 (A7), U15.23 (B7); also elsewhere on the board
VGA_G: J7.2, R16.1, U15.32 (IOG)
VGA_G0: U13.36 (A8), U15.3 (G0); also elsewhere on the board
VGA_G1: U13.35 (A9), U15.4 (G1); also elsewhere on the board
VGA_G2: U13.33 (A10), U15.5 (G2); also elsewhere on the board
VGA_G3: U13.32 (A11), U15.6 (G3); also elsewhere on the board
VGA_G4: U13.30 (A12), U15.7 (G4); also elsewhere on the board
VGA_G5: U13.29 (A13), U15.8 (G5); also elsewhere on the board
VGA_G6: U13.27 (A14), U15.9 (G6); also elsewhere on the board
VGA_G7: U13.26 (A15), U15.10 (G7); also elsewhere on the board
VGA_HS: R19.2, U14.36 (A8); also elsewhere on the board
VGA_R: J7.1, R15.1, U15.34 (IOR)
VGA_R0: U13.47 (A0), U15.41 (R0); also elsewhere on the board
VGA_R1: U13.46 (A1), U15.42 (R1); also elsewhere on the board
VGA_R2: U13.44 (A2), U15.43 (R2); also elsewhere on the board
VGA_R3: U13.43 (A3), U15.44 (R3); also elsewhere on the board
VGA_R4: U13.41 (A4), U15.45 (R4); also elsewhere on the board
VGA_R5: U13.40 (A5), U15.46 (R5); also elsewhere on the board
VGA_R6: U13.38 (A6), U15.47 (R6); also elsewhere on the board
VGA_R7: U13.37 (A7), U15.48 (R7); also elsewhere on the board
VGA_VS: R20.2, U14.35 (A9); also elsewhere on the board
V_CLK: U15.24 (CLOCK); also elsewhere on the board
~FT_INT: R13.1, U12.13 (~INT); also elsewhere on the board
~FT_OE: R14.2, U13.25 (~OE2), U13.48 (~OE1), U14.25 (~OE2), U14.48 (~OE1); also elsewhere on the board
~FT_PD: C110.1, R91.2, R92.2, U12.14 (~PD)
~FT_SPI_CS: U12.8 (~CS); also elsewhere on the board

Notes on the sheet:
FT Audio filter & mixer
FT MCU Reset

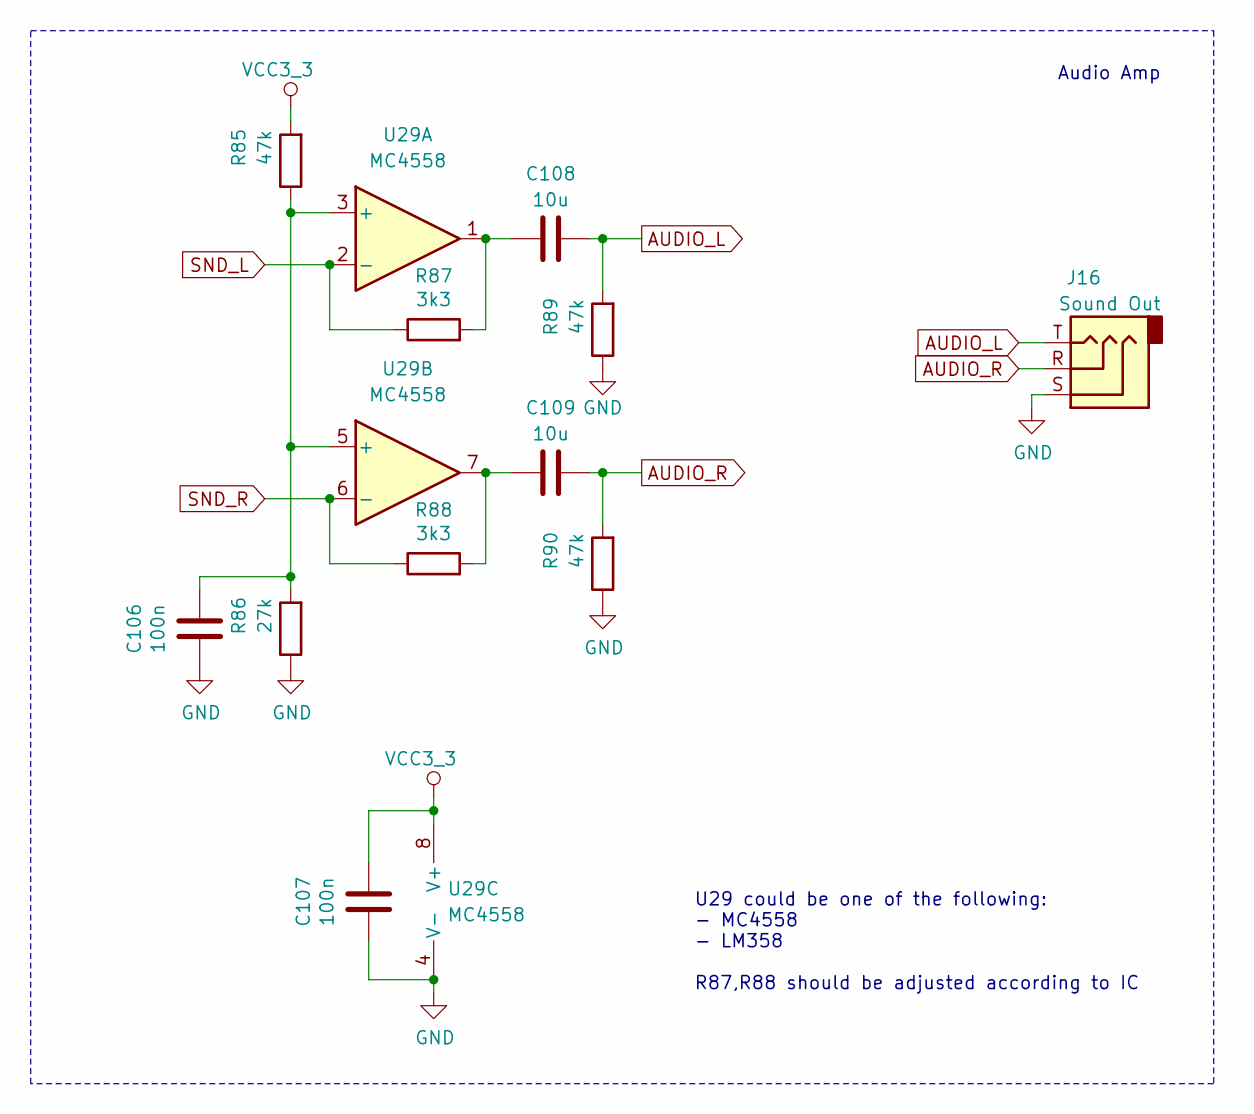
[picture p8: schematic audio.kicad_sch, Karabas-Go]

Parts:
C106, C107: 100n; C_0805_2012Metric_Pad1.18x1.45mm_HandSolder
C108, C109: 10u; C_0805_2012Metric_Pad1.18x1.45mm_HandSolder
J16: Sound Out; Jack_3.5mm_CUI_SJ1-3535NG_Horizontal
R85, R89, R90: 47k; R_0805_2012Metric_Pad1.20x1.40mm_HandSolder
R86: 27k; R_0805_2012Metric_Pad1.20x1.40mm_HandSolder
R87, R88: 3k3; R_0805_2012Metric_Pad1.20x1.40mm_HandSolder
U29: MC4558; SO-8_3.9x4.9mm_P1.27mm

Connections:
AUDIO_L: C108.1, J16.T, R89.2
AUDIO_R: C109.1, J16.R, R90.2
GND: C106.1, C107.1, J16.S, R86.1, R89.1, R90.1, U29.4 (V-); also elsewhere on the board
unnamed: C108.2, R87.2, U29.1
unnamed: C109.2, R88.2, U29.7
unnamed: C106.2, R85.1, R86.2, U29.3 (+), U29.5 (+)
SND_L: R87.1, U29.2 (-); also elsewhere on the board
SND_R: R88.1, U29.6 (-); also elsewhere on the board
VCC3_3: C107.2, R85.2, U29.8 (V+); also elsewhere on the board

Notes on the sheet:
Audio Amp
U29 could be one of the following: - MC4558 - LM358 R87,R88 should be adjusted according to IC
