andykarpov/karabas-go-pcb/karabas-go.kicad_pcb

## KiCad design karabas-go.kicad_pcb (continued)

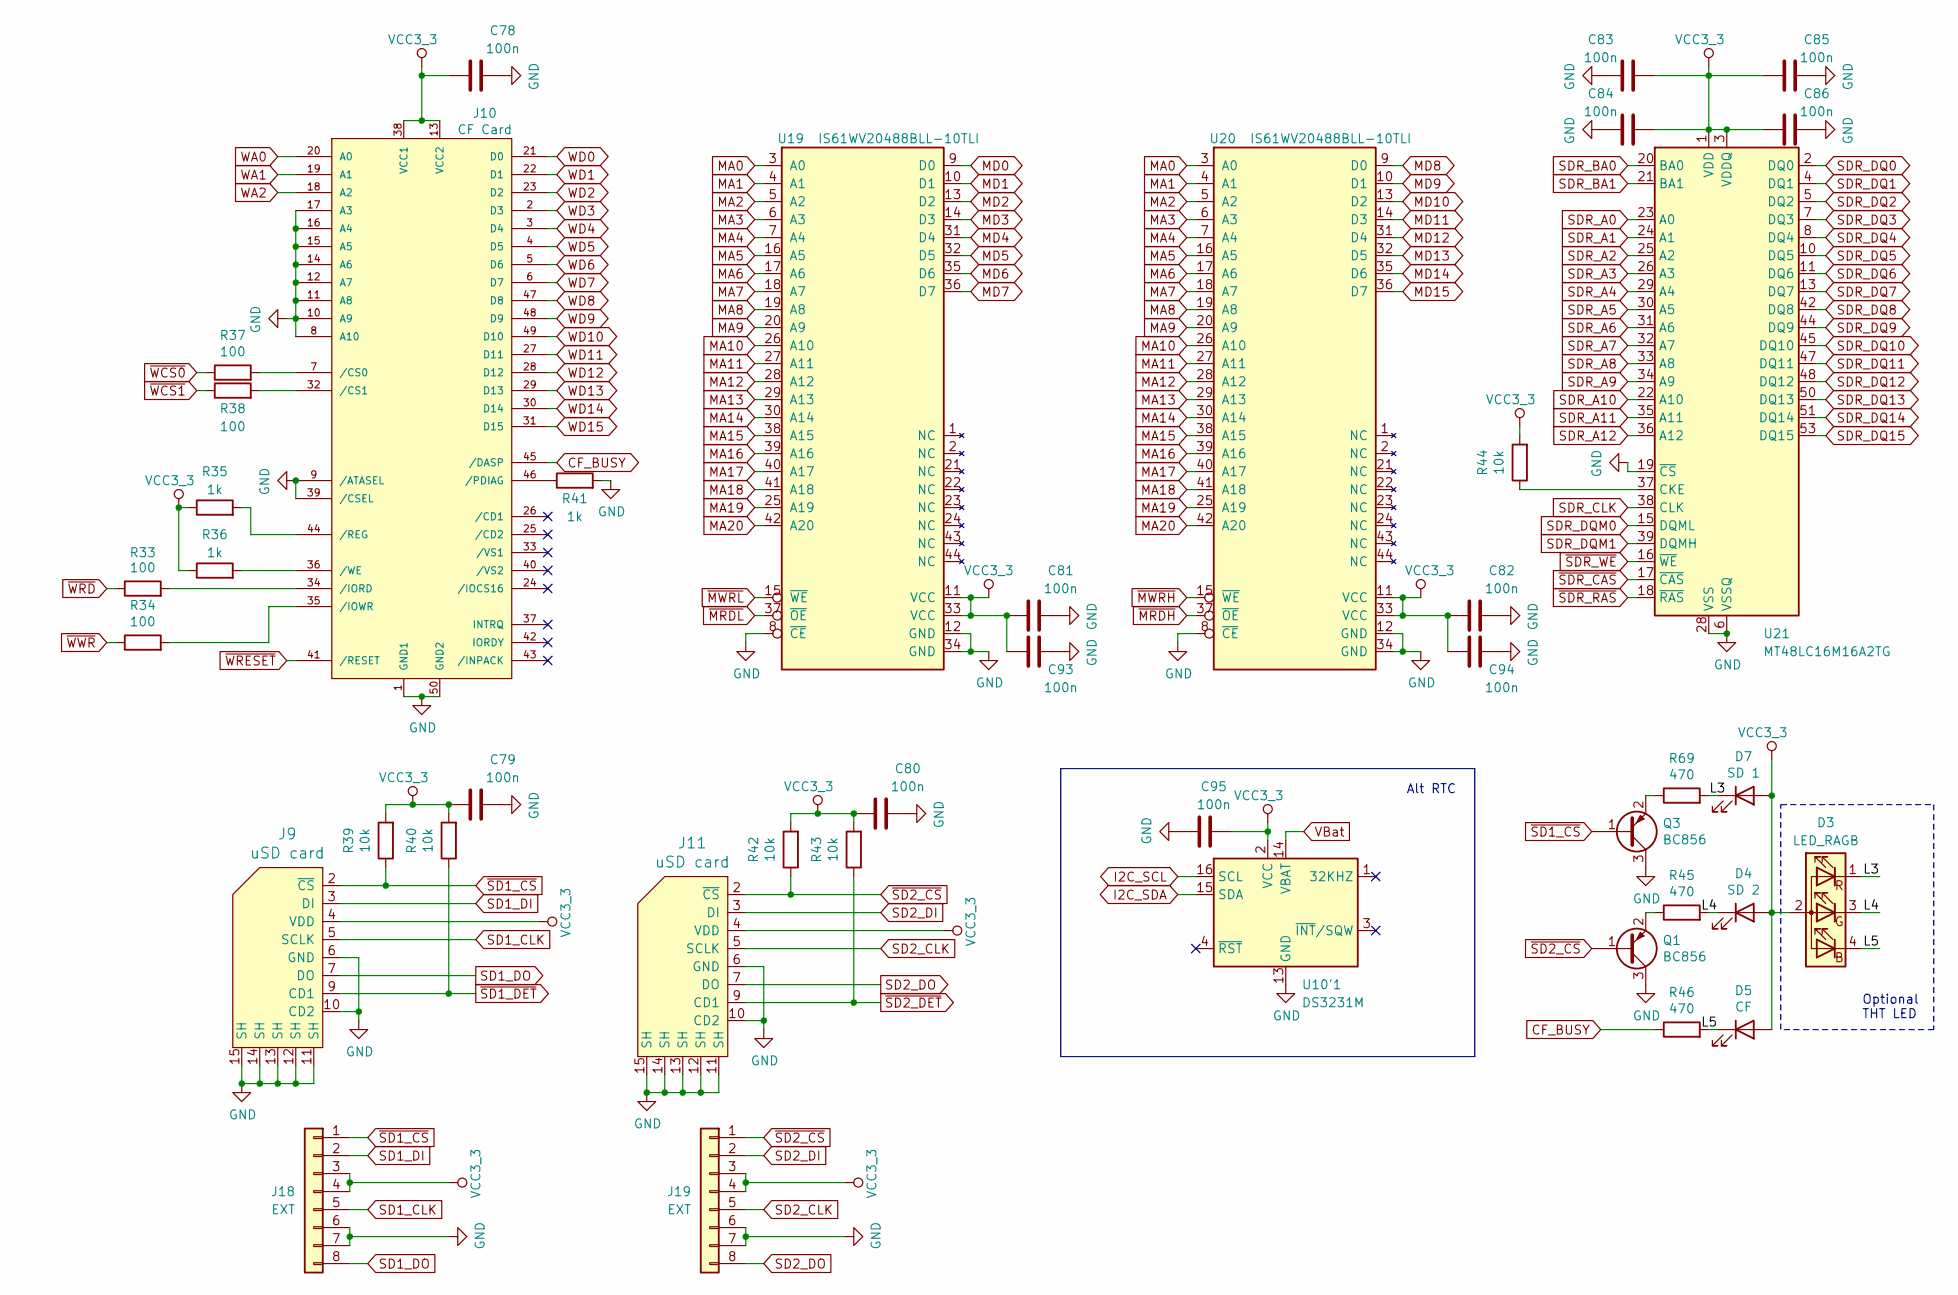
[picture p9: schematic storage.kicad_sch, Karabas-Go]

Parts:
C78, C79, C80, C81, C82, C83, C84, C85, C86, C93, C94, C95: 100n; C_0805_2012Metric_Pad1.18x1.45mm_HandSolder
D3: LED_RAGB; LED_D5.0mm-4_RGB_tiny
D4: SD 2; LED_0805_2012Metric_Pad1.15x1.40mm_HandSolder
D5: CF; LED_0805_2012Metric_Pad1.15x1.40mm_HandSolder
D7: SD 1; LED_0805_2012Metric_Pad1.15x1.40mm_HandSolder
J9, J11: uSD card; Conn_uSDcard
J10: CF Card; TE_1734451-1-LONG
J18, J19: EXT; PinHeader_1x08_P1.27mm_Vertical
Q1, Q3: BC856; SOT-23
R33, R34, R37, R38: 100; R_0805_2012Metric_Pad1.20x1.40mm_HandSolder
R35, R36, R41: 1k; R_0805_2012Metric_Pad1.20x1.40mm_HandSolder
R39, R40, R42, R43, R44: 10k; R_0805_2012Metric_Pad1.20x1.40mm_HandSolder
R45, R46, R69: 470; R_0805_2012Metric_Pad1.20x1.40mm_HandSolder
U10'1: DS3231M; SOIC-16W_7.5x10.3mm_P1.27mm
U19, U20: IS61WV20488BLL-10TLI; TSOP-II-44_10.16x18.41mm_P0.8mm
U21: MT48LC16M16A2TG; TSOP-II-54_22.2x10.16mm_P0.8mm

Connections:
/Storage/L3: D3.1 (RK), D7.1 (K), R69.2
/Storage/L4: D3.3 (GK), D4.1 (K), R45.2
/Storage/L5: D3.4 (BK), D5.1 (K), R46.2
CF_BUSY: J10.45 (/DASP), R46.1
GND: C78.2, C79.2, C80.2, C81.2, C82.2, C83.2, C84.2, C85.2, C86.2, C93.2, C94.2, C95.1, J9.6 (GND), J9.10 (CD2), J9.11 (SH), J9.12 (SH), J9.13 (SH), J9.14 (SH), J9.15 (SH), J10.1 (GND1), J10.8 (A10), J10.9 (/ATASEL), J10.10 (A9), J10.11 (A8), J10.12 (A7), J10.14 (A6), J10.15 (A5), J10.16 (A4), J10.17 (A3), J10.39 (/CSEL), J10.50 (GND2), J11.6 (GND), J11.10 (CD2), J11.11 (SH), J11.12 (SH), J11.13 (SH), J11.14 (SH), J11.15 (SH), J18.6, J18.7, J19.6, J19.7, Q1.3 (C), Q3.3 (C), R41.2, U10'1.5 (GND), U10'1.6 (GND), U10'1.7 (GND), U10'1.8 (GND), U10'1.9 (GND), U10'1.10 (GND), U10'1.11 (GND), U10'1.12 (GND), U10'1.13 (GND), U19.8 (~CE), U19.12 (GND), U19.34 (GND), U20.8 (~CE), U20.12 (GND), U20.34 (GND), U21.6 (VSSQ), U21.12 (VSSQ), U21.19 (~CS), U21.28 (VSS), U21.41 (VSS), U21.46 (VSSQ), U21.52 (VSSQ), U21.54 (VSS); also elsewhere on the board
I2C_SCL: U10'1.16 (SCL); also elsewhere on the board
I2C_SDA: U10'1.15 (SDA); also elsewhere on the board
MA0: U19.3 (A0), U20.3 (A0); also elsewhere on the board
MA1: U19.4 (A1), U20.4 (A1); also elsewhere on the board
MA2: U19.5 (A2), U20.5 (A2); also elsewhere on the board
MA3: U19.6 (A3), U20.6 (A3); also elsewhere on the board
MA4: U19.7 (A4), U20.7 (A4); also elsewhere on the board
MA5: U19.16 (A5), U20.16 (A5); also elsewhere on the board
MA6: U19.17 (A6), U20.17 (A6); also elsewhere on the board
MA7: U19.18 (A7), U20.18 (A7); also elsewhere on the board
MA8: U19.19 (A8), U20.19 (A8); also elsewhere on the board
MA9: U19.20 (A9), U20.20 (A9); also elsewhere on the board
MA10: U19.26 (A10), U20.26 (A10); also elsewhere on the board
MA11: U19.27 (A11), U20.27 (A11); also elsewhere on the board
MA12: U19.28 (A12), U20.28 (A12); also elsewhere on the board
MA13: U19.29 (A13), U20.29 (A13); also elsewhere on the board
MA14: U19.30 (A14), U20.30 (A14); also elsewhere on the board
MA15: U19.38 (A15), U20.38 (A15); also elsewhere on the board
MA16: U19.39 (A16), U20.39 (A16); also elsewhere on the board
MA17: U19.40 (A17), U20.40 (A17); also elsewhere on the board
MA18: U19.41 (A18), U20.41 (A18); also elsewhere on the board
MA19: U19.25 (A19), U20.25 (A19); also elsewhere on the board
MA20: U19.42 (A20), U20.42 (A20); also elsewhere on the board
MD0: U19.9 (D0); also elsewhere on the board
MD1: U19.10 (D1); also elsewhere on the board
MD2: U19.13 (D2); also elsewhere on the board
MD3: U19.14 (D3); also elsewhere on the board
MD4: U19.31 (D4); also elsewhere on the board
MD5: U19.32 (D5); also elsewhere on the board
MD6: U19.35 (D6); also elsewhere on the board
MD7: U19.36 (D7); also elsewhere on the board
MD8: U20.9 (D0); also elsewhere on the board
MD9: U20.10 (D1); also elsewhere on the board
MD10: U20.13 (D2); also elsewhere on the board
MD11: U20.14 (D3); also elsewhere on the board
MD12: U20.31 (D4); also elsewhere on the board
MD13: U20.32 (D5); also elsewhere on the board
MD14: U20.35 (D6); also elsewhere on the board
MD15: U20.36 (D7); also elsewhere on the board
unnamed: J10.7 (/CS0), R37.2
unnamed: J10.32 (/CS1), R38.2
unnamed: J10.34 (/IORD), R33.2
unnamed: J10.35 (/IOWR), R34.2
unnamed: J10.46 (/PDIAG), R41.1
unnamed: J10.44 (/REG), R35.2
unnamed: J10.36 (/WE), R36.2
unnamed: Q1.2 (E), R45.1
unnamed: Q3.2 (E), R69.1
unnamed: R44.1, U21.37 (CKE)
SD1_CLK: J9.5 (SCLK), J18.5; also elsewhere on the board
SD1_DI: J9.3 (DI), J18.2; also elsewhere on the board
SD1_DO: J9.7 (DO), J18.8; also elsewhere on the board
SD2_CLK: J11.5 (SCLK), J19.5; also elsewhere on the board
SD2_DI: J11.3 (DI), J19.2; also elsewhere on the board
SD2_DO: J11.7 (DO), J19.8; also elsewhere on the board
SDR_A0: U21.23 (A0); also elsewhere on the board
SDR_A1: U21.24 (A1); also elsewhere on the board
SDR_A2: U21.25 (A2); also elsewhere on the board
SDR_A3: U21.26 (A3); also elsewhere on the board
SDR_A4: U21.29 (A4); also elsewhere on the board
SDR_A5: U21.30 (A5); also elsewhere on the board
SDR_A6: U21.31 (A6); also elsewhere on the board
SDR_A7: U21.32 (A7); also elsewhere on the board
SDR_A8: U21.33 (A8); also elsewhere on the board
SDR_A9: U21.34 (A9); also elsewhere on the board
SDR_A10: U21.22 (A10); also elsewhere on the board
SDR_A11: U21.35 (A11); also elsewhere on the board
SDR_A12: U21.36 (A12); also elsewhere on the board
SDR_BA0: U21.20 (BA0); also elsewhere on the board
SDR_BA1: U21.21 (BA1); also elsewhere on the board
SDR_CLK: U21.38 (CLK); also elsewhere on the board
SDR_DQ0: U21.2 (DQ0); also elsewhere on the board
SDR_DQ1: U21.4 (DQ1); also elsewhere on the board
SDR_DQ2: U21.5 (DQ2); also elsewhere on the board
SDR_DQ3: U21.7 (DQ3); also elsewhere on the board
SDR_DQ4: U21.8 (DQ4); also elsewhere on the board
SDR_DQ5: U21.10 (DQ5); also elsewhere on the board
SDR_DQ6: U21.11 (DQ6); also elsewhere on the board
SDR_DQ7: U21.13 (DQ7); also elsewhere on the board
SDR_DQ8: U21.42 (DQ8); also elsewhere on the board
SDR_DQ9: U21.44 (DQ9); also elsewhere on the board
SDR_DQ10: U21.45 (DQ10); also elsewhere on the board
SDR_DQ11: U21.47 (DQ11); also elsewhere on the board
SDR_DQ12: U21.48 (DQ12); also elsewhere on the board
SDR_DQ13: U21.50 (DQ13); also elsewhere on the board
SDR_DQ14: U21.51 (DQ14); also elsewhere on the board
SDR_DQ15: U21.53 (DQ15); also elsewhere on the board
SDR_DQM0: U21.15 (DQML); also elsewhere on the board
SDR_DQM1: U21.39 (DQMH); also elsewhere on the board
VBat: U10'1.14 (VBAT); also elsewhere on the board
VCC3_3: C78.1, C79.1, C80.1, C81.1, C82.1, C83.1, C84.1, C85.1, C86.1, C93.1, C94.1, C95.2, D3.2 (A), D4.2 (A), D5.2 (A), D7.2 (A), J9.4 (VDD), J10.13 (VCC2), J10.38 (VCC1), J11.4 (VDD), J18.3, J18.4, J19.3, J19.4, R35.1, R36.1, R39.2, R40.2, R42.2, R43.2, R44.2, U10'1.2 (VCC), U19.11 (VCC), U19.33 (VCC), U20.11 (VCC), U20.33 (VCC), U21.1 (VDD), U21.3 (VDDQ), U21.9 (VDDQ), U21.14 (VDD), U21.27 (VDD), U21.43 (VDDQ), U21.49 (VDDQ); also elsewhere on the board
WA0: J10.20 (A0); also elsewhere on the board
WA1: J10.19 (A1); also elsewhere on the board
WA2: J10.18 (A2); also elsewhere on the board
WD0: J10.21 (D0); also elsewhere on the board
WD1: J10.22 (D1); also elsewhere on the board
WD2: J10.23 (D2); also elsewhere on the board
WD3: J10.2 (D3); also elsewhere on the board
WD4: J10.3 (D4); also elsewhere on the board
WD5: J10.4 (D5); also elsewhere on the board
WD6: J10.5 (D6); also elsewhere on the board
WD7: J10.6 (D7); also elsewhere on the board
WD8: J10.47 (D8); also elsewhere on the board
WD9: J10.48 (D9); also elsewhere on the board
WD10: J10.49 (D10); also elsewhere on the board
WD11: J10.27 (D11); also elsewhere on the board
WD12: J10.28 (D12); also elsewhere on the board
WD13: J10.29 (D13); also elsewhere on the board
WD14: J10.30 (D14); also elsewhere on the board
WD15: J10.31 (D15); also elsewhere on the board
~MRDH: U20.37 (~OE); also elsewhere on the board
~MRDL: U19.37 (~OE); also elsewhere on the board
~MWRH: U20.15 (~WE); also elsewhere on the board
~MWRL: U19.15 (~WE); also elsewhere on the board
~SD1_CS: J9.2 (~CS), J18.1, Q3.1 (B), R39.1; also elsewhere on the board
~SD1_DET: J9.9 (CD1), R40.1
~SD2_CS: J11.2 (~CS), J19.1, Q1.1 (B), R42.1; also elsewhere on the board
~SD2_DET: J11.9 (CD1), R43.1; also elsewhere on the board
~SDR_CAS: U21.17 (~CAS); also elsewhere on the board
~SDR_RAS: U21.18 (~RAS); also elsewhere on the board
~SDR_WE: U21.16 (~WE); also elsewhere on the board
~WCS0: R37.1; also elsewhere on the board
~WCS1: R38.1; also elsewhere on the board
~WRD: R33.1; also elsewhere on the board
~WRESET: J10.41 (/RESET); also elsewhere on the board
~WWR: R34.1; also elsewhere on the board

Notes on the sheet:
Optional THT LED
Alt RTC

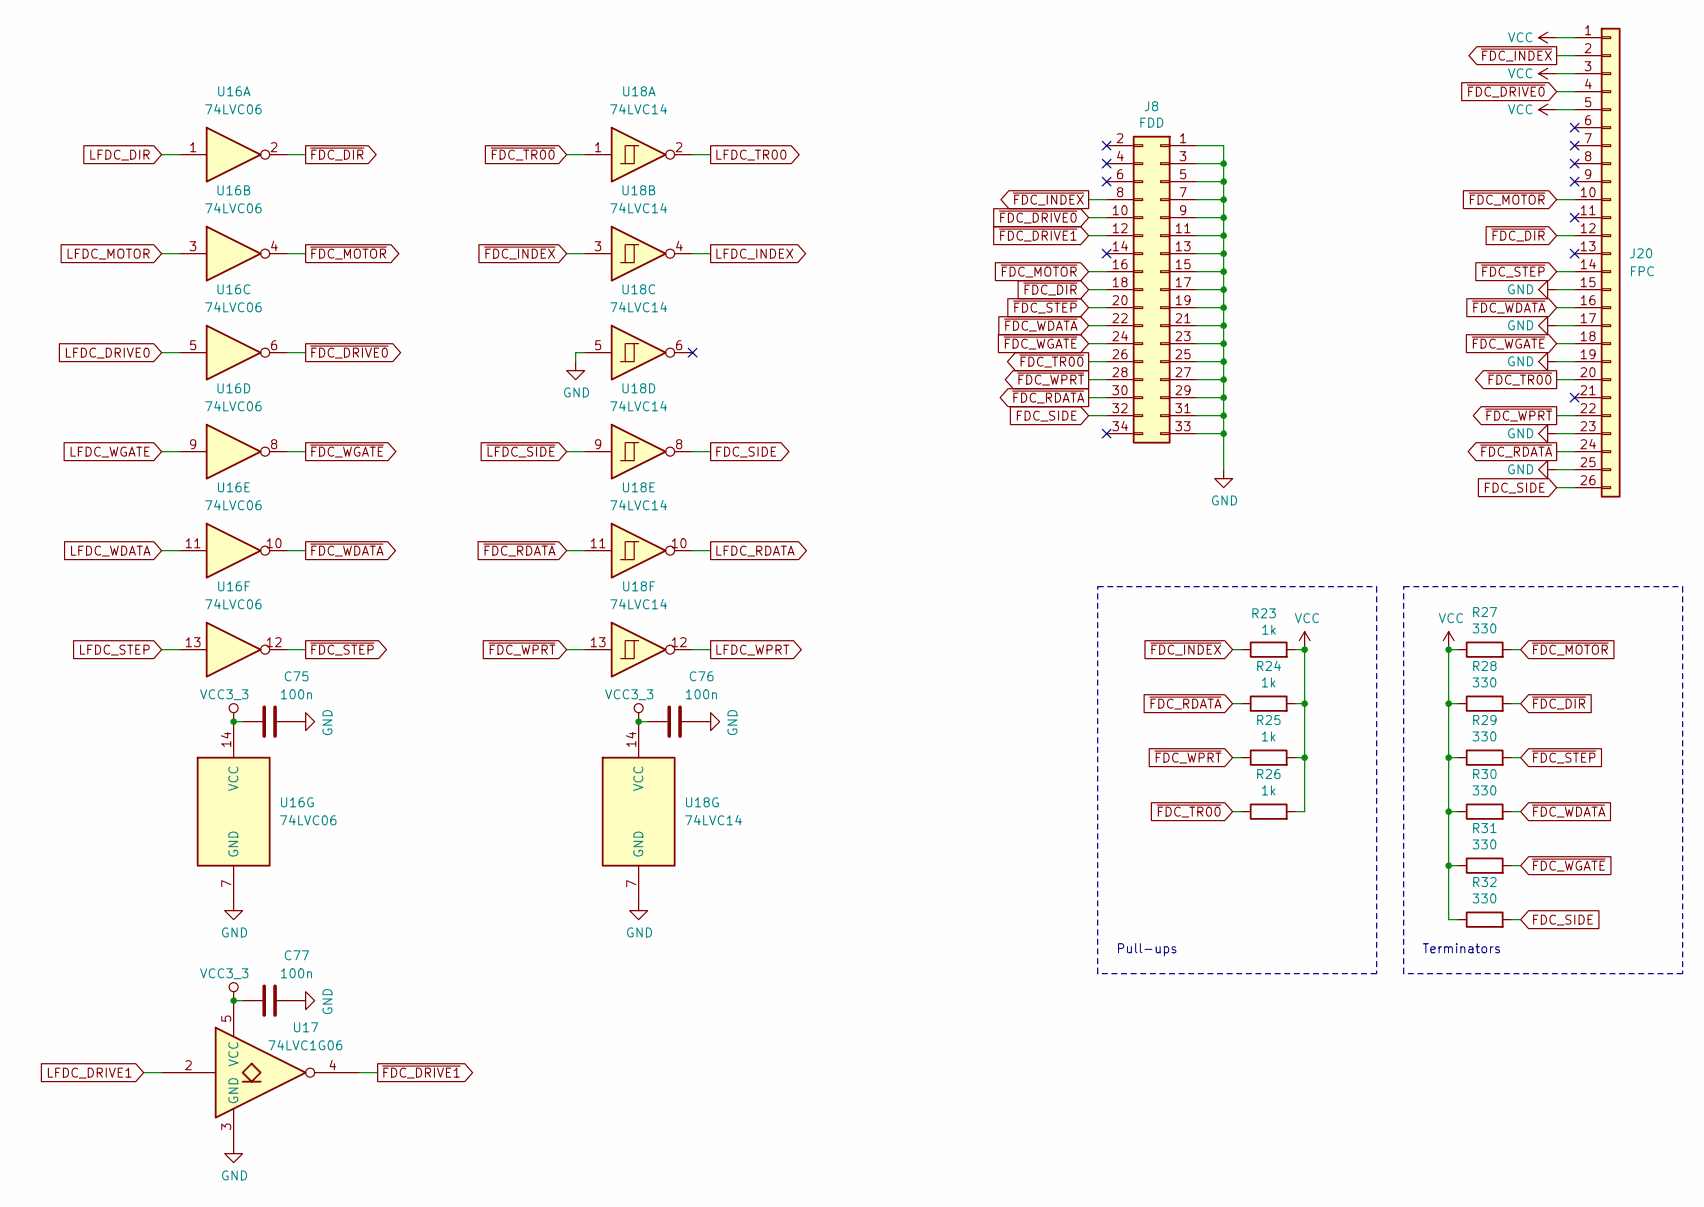
[picture p10: schematic fdc.kicad_sch, Karabas-Go]

Parts:
C75, C76, C77: 100n; C_0805_2012Metric_Pad1.18x1.45mm_HandSolder
J8: FDD; IDC-Header_2x17_P2.54mm_Vertical
J20: FPC; TE_2-84952-6_1x26-1MP_P1.0mm_Horizontal
R23, R24, R25, R26: 1k; R_0805_2012Metric_Pad1.20x1.40mm_HandSolder
R27, R28, R29, R30, R31, R32: 330; R_0805_2012Metric_Pad1.20x1.40mm_HandSolder
U16: 74LVC06; SO-14_3.9x8.65mm_P1.27mm
U17: 74LVC1G06; SOT-23-5_HandSoldering
U18: 74LVC14; SO-14_3.9x8.65mm_P1.27mm

Connections:
FDC_SIDE: J8.32, J20.26, R32.2, U18.8
GND: C75.2, C76.2, C77.2, J8.1, J8.3, J8.5, J8.7, J8.9, J8.11, J8.13, J8.15, J8.17, J8.19, J8.21, J8.23, J8.25, J8.27, J8.29, J8.31, J8.33, J20.15, J20.17, J20.19, J20.23, J20.25, U16.7 (GND), U17.3 (GND), U18.5, U18.7 (GND); also elsewhere on the board
LFDC_DIR: U16.1; also elsewhere on the board
LFDC_DRIVE0: U16.5; also elsewhere on the board
LFDC_DRIVE1: U17.2; also elsewhere on the board
LFDC_INDEX: U18.4; also elsewhere on the board
LFDC_MOTOR: U16.3; also elsewhere on the board
LFDC_RDATA: U18.10; also elsewhere on the board
LFDC_STEP: U16.13; also elsewhere on the board
LFDC_TR00: U18.2; also elsewhere on the board
LFDC_WDATA: U16.11; also elsewhere on the board
LFDC_WGATE: U16.9; also elsewhere on the board
LFDC_WPRT: U18.12; also elsewhere on the board
VCC: J20.1, J20.3, J20.5, R23.2, R24.2, R25.2, R26.2, R27.1, R28.1, R29.1, R30.1, R31.1, R32.1; also elsewhere on the board
VCC3_3: C75.1, C76.1, C77.1, U16.14 (VCC), U17.5 (VCC), U18.14 (VCC); also elsewhere on the board
~FDC_DIR: J8.18, J20.12, R28.2, U16.2
~FDC_DRIVE0: J8.10, J20.4, U16.6
~FDC_DRIVE1: J8.12, U17.4
~FDC_INDEX: J8.8, J20.2, R23.1, U18.3
~FDC_MOTOR: J8.16, J20.10, R27.2, U16.4
~FDC_RDATA: J8.30, J20.24, R24.1, U18.11
~FDC_STEP: J8.20, J20.14, R29.2, U16.12
~FDC_TR00: J8.26, J20.20, R26.1, U18.1
~FDC_WDATA: J8.22, J20.16, R30.2, U16.10
~FDC_WGATE: J8.24, J20.18, R31.2, U16.8
~FDC_WPRT: J8.28, J20.22, R25.1, U18.13
~LFDC_SIDE: U18.9; also elsewhere on the board

Notes on the sheet:
Terminators
Pull-ups

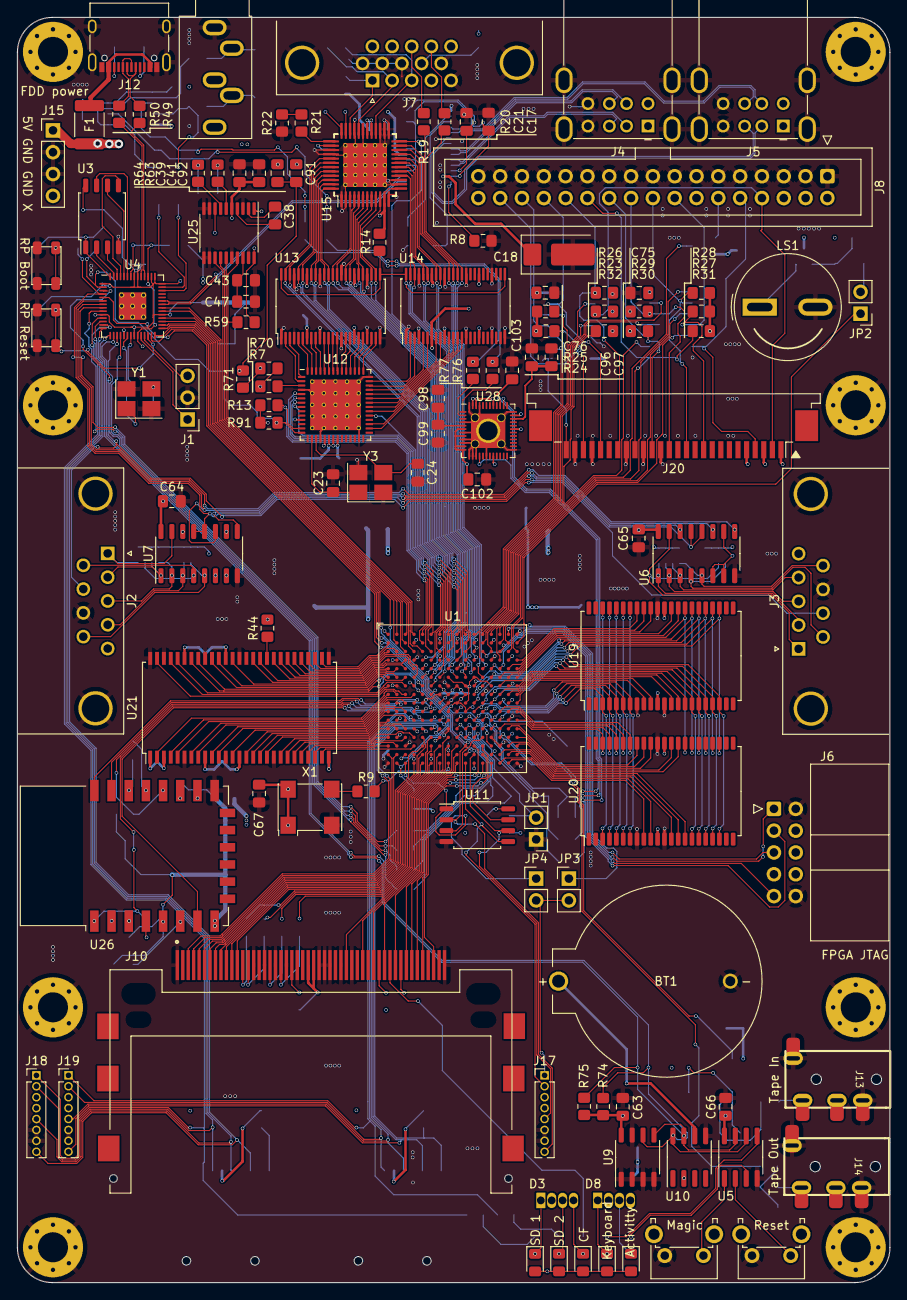
[picture p11: board karabas-go.kicad_pcb from above]

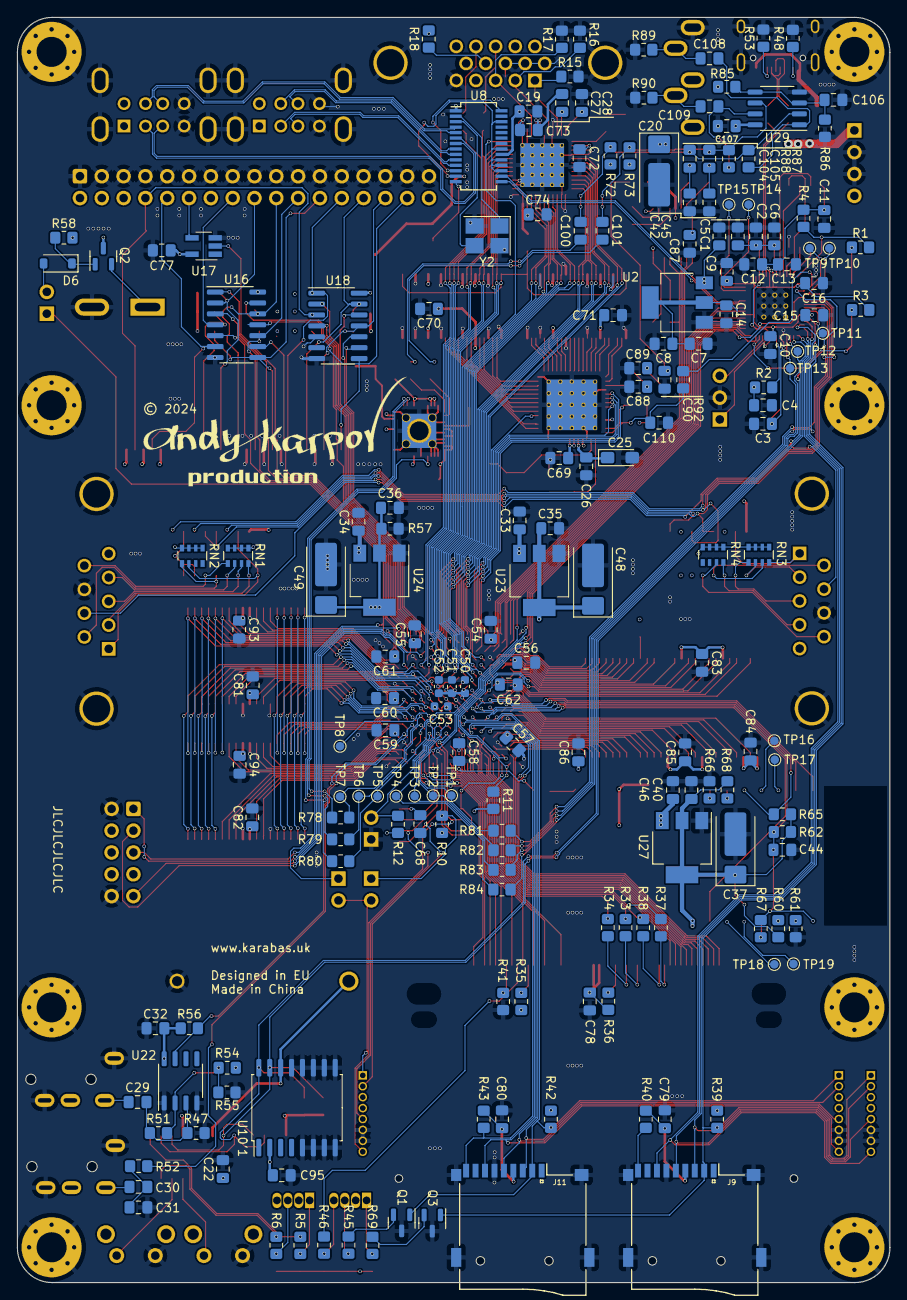
[picture p12: board karabas-go.kicad_pcb from below]

Board: 4 copper layers, 101.6 x 147.3 mm, 309 parts (186 on the bottom side), 387 nets.
