andykarpov/karabas-go-pcb/(notices)

Notices in the files:
karabas-go.kicad_pcb:
© 2024
